PI2-Estufa/all-documents-PI2/Fotos e vídeos/Estufa pronta/IMG-20180627-WA0025.jpg

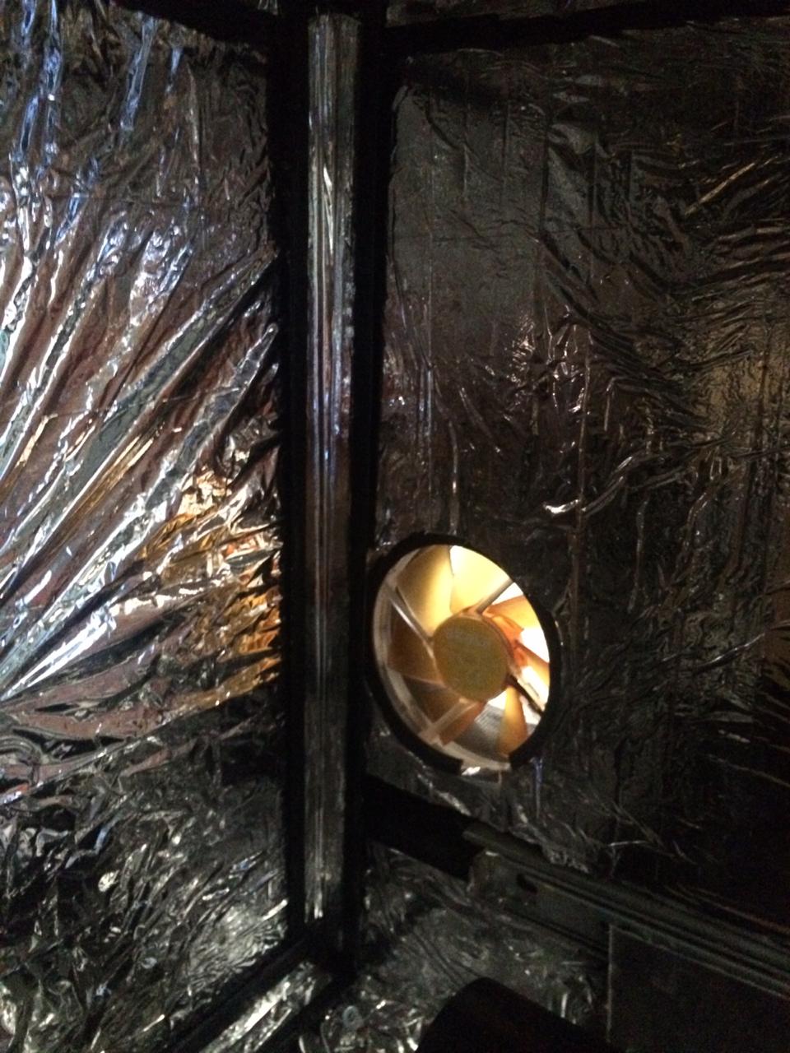
Fotos e vídeos/Estufa pronta/IMG-20180627-WA0025.jpg
