PI2-Estufa/all-documents-PI2/Fotos e vídeos/Fotos e vídeos/D4DB0FEE-51A9-4ACD-BE4B-FF01E593BEB5.jpg

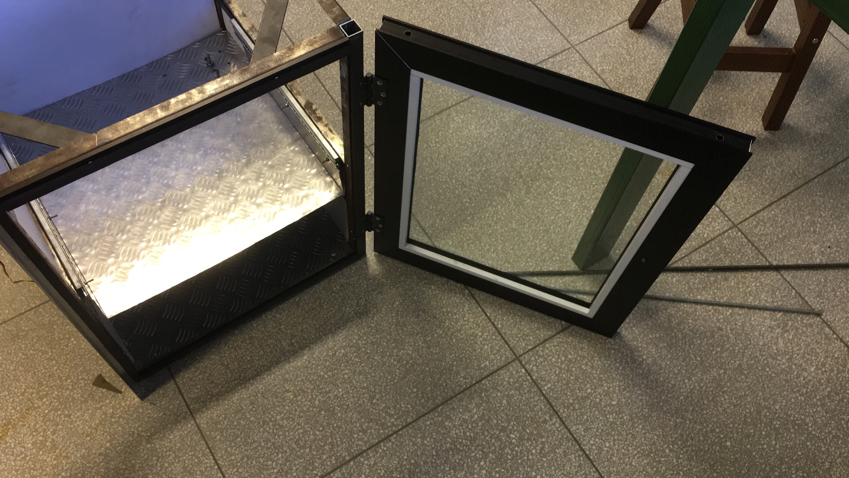
Fotos e vídeos/Fotos e vídeos/D4DB0FEE-51A9-4ACD-BE4B-FF01E593BEB5.jpg
