PI2-Estufa/all-documents-PI2/Estrutura/Report Preview Estufa - Tranferência de Calor.pdf

# Project

First Saved | Wednesday, June 27, 2018
Last Saved | Thursday, June 28, 2018
Product Version | 19.0 Release
Save Project Before Solution | No
Save Project After Solution | No
Project | Page 1 of 17

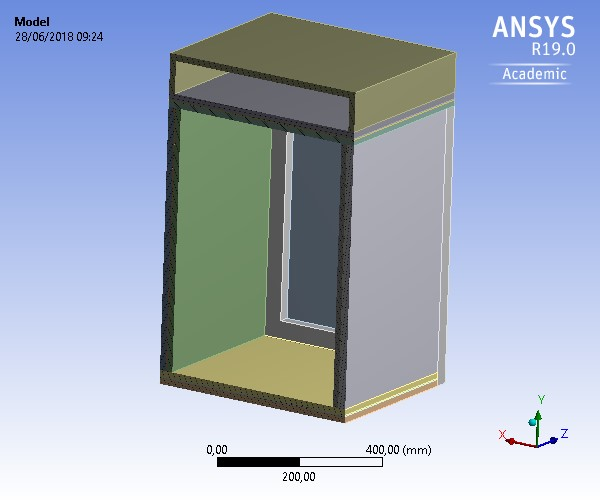
[picture p45: figure]

file:///C:/Users/Thiago/AppData/Roaming/Ansys/v190/Mechanical_Report/Mechanic... 28/06/2018

# Contents

l Units

l Model (A4)
¡ Geometry
n Parts
¡ Coordinate Systems
¡ Connections
n Contacts
n Contact Regions
¡ Mesh
¡ Transient Thermal (A5)
n Initial Temperature
n Analysis Settings
n Loads
n Solution (A6)
n Solution Information
n Result Charts
n Results

l Material Data
¡ Air(Atmospheric)
¡ PVC
¡ Isopor
¡ Wood
¡ Aluminum Alloy
¡ Glass

# Units

TABLE 1

# Model (A4)

Unit System | Metric (mm, kg, N, s, mV, mA) Degrees rad/s Celsius
Angle | Degrees
Rotational Velocity | rad/s
Temperature | Celsius

## Geometry

TABLE 2 Model (A4) > Geometry

TABLE 3 Model (A4) > Geometry > Parts

Object Name | Geometry
State | Fully Defined
Definition
Source | C:\Users\Thiago\Desktop\Estufa_camadas\estufa_camadas_files\dp0\SYS\DM\SYS.scdoc
Type | SpaceClaim
Length Unit | Meters
Element Control | Program Controlled
Display Style | Body Color
Bounding Box
Length X | 535, mm
Length Y | 835, mm
Length Z | 570, mm
Properties
Volume | 2,3479e+008 mm³ Mass 33,764 kg
Scale Factor Value | 1,
Statistics
Bodies | 19
Active Bodies | 19
Nodes | 27281
Elements | None 4421 Mesh Metric

Basic Geometry Options
Solid Bodies | Yes
Surface Bodies | Yes
Line Bodies | Yes
Parameters | Independent
Parameter Key
Attributes | Yes
Attribute Key
Named Selections | Yes
Named Selection Key Material Properties | Yes

Advanced Geometry Options
Use Associativity | Yes
Coordinate Systems | Yes
Coordinate System Key
Reader Mode Saves Updated File | No
Use Instances | Yes
Smart CAD Update | Yes
Compare Parts On Update | No
Analysis Type | None 3-D Mixed Import Resolution
Decompose Disjoint Geometry | Yes
Enclosure and Symmetry Processing | Yes
Project | Page 2 of 17

TABLE 4 Model (A4) > Geometry > Parts

Object Name | parte_tras\forro | parte_tras\pvc | parte_tras\isopor | parte_baixo\isopor | parte_baixo\pvc | parte_baixo\forro | parte_esquerda\isopor | parte_esquerda\pvc | parte_esquerda\forro
State | | | | | | Meshed Graphics Properties
Visible | | | | | | Yes
Transparency | | | | | | 1
Definition
Suppressed | | | | | | No
Stiffness Behavior | | | | | | Flexible
Coordinate
System | Default Coordinate System
Reference
Temperature | By Environment
Behavior | | | | | | None Material
Assignment | Air
(Atmospheric) | PVC | Isopor | PVC | Air(Atmospheric) | Isopor | PVC | Air(Atmospheric)
Nonlinear Effects | | | | | | Yes
Thermal Strain
Effects | | | | | | Yes
Bounding Box
Length X | 535, mm | 17, mm | 3,5 mm | 15, mm
Length Y | | 665, mm | | 17, mm | 3, mm | 15, mm | | | 665, mm
Length Z | 15, mm | 3, mm | 17, mm | | 535, mm | | | | 500, mm
Properties
Volume | 5,3366e+006 mm³ | 1,0673e+006 mm³ | 6,0482e+006 mm³ | 4,8658e+006 mm³ | 8,5867e+005 mm³ | 4,2934e+006 mm³ | 5,6525e+006 mm³ | 1,1638e+006 mm³ | 4,9875e+006 mm
Mass | 6,5374e-003 kg | 1,2808 kg | 0,30241 kg | 0,24329 kg | 1,0304 kg | 5,2594e-003 kg | 0,28263 kg | 1,3965 kg | 6,1097e
Centroid X | 267,5 mm | 8,5 mm | 18,75 mm | 28, mm
Centroid Y | 367,5 mm | 8,5 mm | 18,5 mm | 27,5 mm | 367,5 mm
Centroid Z | -507,5 mm | -516,5 mm | -526,5 mm | -267,5 mm | -250, mm
Moment of Inertia
Ip1 | 241,04 kg·mm² | 47201 kg·mm² | 11152 kg·mm² | 5808,9 kg·mm² | 24578 kg·mm² | 125,55 kg·mm² | 16303 kg·mm² | 80558 kg·mm² | 352,44 kg·mm
Moment of Inertia
Ip2 | 156,05 kg·mm² | 30551 kg·mm² | 7220,4 kg·mm² | 11606 kg·mm² | 49155 kg·mm² | 250,89 kg·mm² | 5894,8 kg·mm² | 29095 kg·mm² | 127,4
Moment of Inertia
Ip3 | 396,84 kg·mm² | 77750 kg·mm² | 18357 kg·mm² | 5808,9 kg·mm² | 24578 kg·mm² | 125,55 kg·mm² | 10422 kg·mm² | 51465 kg·mm² | 225,27 kg·mm
| | | | | | Statistics
Nodes | | 1206 | | | 1131 | | | | 1206
Elements | 154 | 144 | 154 Mesh Metric | None

CAD Attributes
PartTolerance: | 0,00000001
Color:192.192.192
Object Name | Component8\pvc | Component10
\forro

Component11
\pvc

Component12
\isopor | madeira\Solid | porta\Solid | vidro\Solid | ar\Solid
State | Meshed | Hidden Graphics Properties
Visible | Yes | No
Transparency | 1
Definition
Suppressed | No
Stiffness Behavior | Flexible
Coordinate System | Default Coordinate System
Reference Temperature | By Environment
Behavior | None Material
Assignment | PVC | Air(Atmospheric) | PVC | Isopor | Wood | Aluminum Alloy | Glass | Air (Atmospheric)
Nonlinear Effects | Yes
Thermal Strain Effects | Yes
Bounding Box
Length X | 3,5 mm | 535, mm | 375, mm | 464, mm
Length Y | 665, mm | 15, mm | 3, mm | 17, mm | 100, mm | 700, mm | 540, mm | 700, mm
Length Z | 500, mm | 570, mm | | | | 35, mm | 7, mm | 500, mm
Properties
Volume | 1,1637e+006 mm³ 1,3965 kg | 4,5743e+006 mm³ 5,6035e-003 kg | 9,1485e+005 mm³ 1,0978 kg | 5,1842e+006 mm³ 0,25921 kg | 8,2065e+006 mm³ 5,7446 kg | 6,02e+006 mm³ 16,675 kg | 1,4175e+006 mm³ 3,5437 kg | 1,624e+008 mm³ Mass 0,19894 kg
Centroid X | 516,25 mm | 267,5 mm
Centroid Y | 367,5 mm | 707,5 mm | 716,5 mm | 726,5 mm | 808,09 mm | 350, mm | | 385, mm
Centroid Z | -250, mm | | | | | 17,5 mm | 31,5 mm | -250, mm
Moment of Inertia Ip1 | 80557 kg·mm² | 151,82 kg·mm² | 29725 kg·mm² | 7024,3 kg·mm² | 2,0907e+005 kg·mm² | 1,0072e+006 kg·mm² | 86128 kg·mm² | 12268 kg·mm²
Moment of Inertia Ip2 | 29095 kg·mm² | 285,37 kg·mm² | 55909 kg·mm² | 13201 kg·mm² | 3,8724e+005 kg·mm² | 6,3765e+005 kg·mm² | 41543 kg·mm² | 7713,8 kg·mm²
Moment of Inertia Ip3 | 51465 kg·mm² | 133,76 kg·mm² | 26186 kg·mm² | 6188,9 kg·mm² | 1,8746e+005 kg·mm² | 1,6414e+006 kg·mm² | 1,2764e+005 kg·mm² | 11693 kg·mm²

Statistics
Nodes | 1206 | 1220 | 1494 | 773 | 932 | 6175
Elements | 154 | 156 | 679 | 79 | 117 | 1260 Mesh Metric | None

CAD Attributes
PartTolerance: | 0,00000001
Color:192.192.192
Color:175.175.143
Color:0.0.0
Color:255.255.255

## Coordinate Systems

Project | Page 3 of 17

TABLE 5 Model (A4) > Coordinate Systems > Coordinate System

Object Name | Global Coordinate System
State | Fully Defined
Definition
Type | Cartesian
Coordinate System ID | 0,
Origin
Origin X | 0, mm
Origin Y | 0, mm
Origin Z | 0, mm
Directional Vectors
X Axis Data | [ 1, 0, 0, ]
Y Axis Data | [ 0, 1, 0, ]
Z Axis Data | [ 0, 0, 1, ]

## Connections

TABLE 6 Model (A4) > Connections

TABLE 7 Model (A4) > Connections > Contacts

TABLE 8 Model (A4) > Connections > Contacts > Contact Regions

TABLE 9

Object Name | Connections
State | Fully Defined
Auto Detection Generate Automatic Connection On Refresh | Yes

Transparency
Enabled | Yes
Object Name | Contacts
State | Fully Defined
Definition
Connection Type Contact
Scope
Scoping Method | Geometry Selection
Geometry | All Bodies
Auto Detection
Tolerance Type | Slider
Tolerance Slider | 0,
Tolerance Value | 2,8596 mm
Use Range | No
Face/Face | Yes
Face Overlap Tolerance | Off
Cylindrical Faces | Include
Face/Edge | No
Edge/Edge | No
Priority | Include All Group By Bodies
Search Across | Bodies
Statistics
Connections | 51
Active Connections | 51
Object Name | Contact Region

Contact Region

2 | Contact Region 3 | Contact Region 4 | Contact Region 5 | Contact Region 6

Contact Region 7

Contact Region 8

Contact Region 9

Contact Region
10
State | Fully Defined
| | | Scope
Scoping Method | Geometry Selection
Contact | 1 Face
Target | 1 Face
Contact
Bodies | parte_tras\forro
Target
Bodies | parte_tras\pvc | parte_baixo\forro | parte_esquerda\isopor | parte_esquerda\pvc | parte_esquerda\forro | Component7 \isopor

Component9
\forro

Component8
\pvc

Component10
\forro | parte_tras\isopor
Protected | | | | | No
| | | | | Definition
Type | | | | | Bonded
Scope Mode | Automatic
Behavior | Program Controlled
Trim Contact | Program Controlled
Trim
Tolerance | 2,8596 mm
Suppressed | | | | | No
| | | | | Advanced
Formulation | Program Controlled
Small Sliding | Program Controlled
Detection Method | Program Controlled

Elastic Slip
Tolerance | Program Controlled
Thermal Conductance | Program Controlled
Pinball Region | Program Controlled

Geometric Modification
Contact Geometry Correction | | | | | None

Target
Geometry Correction | | | | | None
Project | Page 4 of 17

Model (A4) > Connections > Contacts > Contact Regions

TABLE 10 Model (A4) > Connections > Contacts > Contact Regions

TABLE 11 Model (A4) > Connections > Contacts > Contact Regions

Object Name Contact Region 12

Contact Region
13

Contact Region 14

Contact Region
15

Contact Region 16

Contact Region
17
| | | | Contact Region 18 | Contact Region 19 | Contact Region 20 | Contact Region 21
State | Fully Defined
| | | Scope
Scoping Method | Geometry Selection
Contact | 1 Face
Target | 1 Face
Contact
Bodies | parte_tras\pvc | parte_tras\isopor | parte_baixo\isopor | parte_baixo\pvc | parte_baixo\forro
Target
Bodies

Component10

\forro | parte_baixo\forro | Component10
\forro | parte_baixo\pvc | porta\Solid | parte_baixo\forro | porta\Solid | parte_esquerda\isopor | parte_esquerda\pvc | parte_esquerda\forro
Protected | No
| | | Definition
Type | Bonded
Scope Mode | Automatic
Behavior | Program Controlled
Trim Contact | Program Controlled
Trim
Tolerance | 2,8596 mm
Suppressed | No
| | | Advanced
Formulation | Program Controlled
Small Sliding | Program Controlled
Detection Method | Program Controlled

Elastic Slip
Tolerance | Program Controlled
Thermal Conductance | Program Controlled
Pinball Region | Program Controlled

Geometric Modification
Contact Geometry Correction
None

Target
Geometry Correction

None

Object Name | Contact Region 23 | Contact Region 24 | Contact Region 25 | Contact Region 26 | Contact Region 27 | Contact Region 28 | Contact Region 29 | Contact Region 30 | Contact Region 31 | Contact Region 32 | Contact Region 33
State | Fully Defined
Scope
Scoping Method | Geometry Selection
Contact | 1 Face
Target | 1 Face
Contact Bodies | parte_baixo\forro | parte_esquerda\isopor | parte_esquerda\pvc | parte_esquerda\forro
Target Bodies | Component9 \forro | Component8 \pvc | porta\Solid | parte_esquerda\pvc | Component10 \forro | porta\Solid | parte_esquerda\forro | Component10 \forro | porta\Solid | Component10 \forro | porta\Solid
Protected | No
Definition
Type | Bonded
Scope Mode | Automatic
Behavior | Program Controlled
Trim Contact | Program Controlled
Trim Tolerance | 2,8596 mm
Suppressed | No
Advanced
Formulation | Program Controlled
Small Sliding | Program Controlled
Detection Method | Program Controlled
Elastic Slip Tolerance | Program Controlled
Thermal Conductance | Program Controlled
Pinball Region | Program Controlled

Geometric Modification
Contact Geometry Correction | None
Target Geometry Correction | None
Object Name | Contact Region 34 | Contact Region 35 | Contact Region 36 | Contact Region 37 | Contact Region 38 | Contact Region 39 | Contact Region 40 | Contact Region 41 | Contact Region 42 | Contact Region 43 | Contact Region 44
State | Fully Defined
Scope
Scoping Method | Geometry Selection
Contact | 1 Face
Target | 1 Face
Contact Bodies | Component7\isopor | Component9\forro | Component8\pvc | Component10\forro | Component11 \pvc
Target Bodies | Component8 \pvc | Component10 \forro | porta\Solid | Component8 \pvc | Component10 \forro | porta\Solid | Component10 \forro | porta\Solid | Component11 \pvc | porta\Solid | Component12 \isopor
Protected | No
Definition
Project | Page 5 of 17

TABLE 12 Model (A4) > Connections > Contacts > Contact Regions

Type | Bonded
Scope Mode | Automatic
Behavior | Program Controlled
Trim Contact | Program Controlled
Trim Tolerance | 2,8596 mm
Suppressed | No
Advanced
Formulation | Program Controlled
Small Sliding | Program Controlled
Detection Method | Program Controlled
Elastic Slip Tolerance | Program Controlled
Thermal Conductance | Program Controlled
Pinball Region | Program Controlled Geometric Modification
Contact Geometry Correction | None
Target Geometry Correction | None
Object Name | Contact Region 45 | Contact Region 46 | Contact Region 47 | Contact Region 48 | Contact Region 49 | Contact Region 50 | Contact Region 51
State | Fully Defined
Scope
Scoping Method | Geometry Selection
Contact | 1 Face | 4 Faces | 1 Face
Target | 1 Face | 4 Faces | 1 Face
Contact Bodies | Component12\isopor | porta\Solid | parte_tras\forro | parte_baixo\forro | parte_esquerda\forro | Component9\forro | porta\Solid
Target Bodies | madeira\Solid | vidro\Solid | ar\Solid
Protected | No
Definition
Type | Bonded
Scope Mode | Automatic
Behavior | Program Controlled
Trim Contact | Program Controlled
Trim Tolerance | 2,8596 mm
Suppressed | No
Advanced
Formulation | Program Controlled
Small Sliding | Program Controlled
Detection Method | Program Controlled
Elastic Slip Tolerance | Program Controlled
Thermal Conductance | Program Controlled
Pinball Region | Program Controlled Geometric Modification
Contact Geometry Correction | None
Target Geometry Correction | None

## Mesh

TABLE 13 Model (A4) > Mesh

Object Name | Mesh
State | Solved
Display
Display Style | Body Color
Defaults
Physics Preference | Mechanical
Relevance | 0
Element Order | Program Controlled
Sizing
Size Function | Adaptive
Relevance Center | Coarse
Element Size | Default Mesh Defeaturing Yes
Defeature Size | Default
Transition | Fast
Initial Size Seed | Assembly
Span Angle Center | Coarse
Bounding Box Diagonal | 1143,80 mm
Average Surface Area | 1,1221e+005 mm² Minimum Edge Length 3,0 mm

Quality
Check Mesh Quality | Yes, Errors
Error Limits | Standard Mechanical
Target Quality | Default (0.050000)
Smoothing | Medium
Mesh Metric | None
Inflation
Use Automatic Inflation | None
Inflation Option | Smooth Transition
Transition Ratio | 0,272
Maximum Layers | 1,2 5 Growth Rate
Inflation Algorithm | Pre
View Advanced Options | No
Advanced
Number of CPUs for Parallel Part Meshing | Program Controlled
Straight Sided Elements | No
Number of Retries | Default (4)
Project | Page 6 of 17

# Transient Thermal (A5)

TABLE 14 Model (A4) > Analysis

TABLE 15 Model (A4) > Transient Thermal (A5) > Initial Condition

TABLE 16 Model (A4) > Transient Thermal (A5) > Analysis Settings

TABLE 17 Model (A4) > Transient Thermal (A5) > Analysis Settings

Step-Specific "Step Controls"

TABLE 18 Model (A4) > Transient Thermal (A5) > Loads

Rigid Body Behavior | Dimensionally Reduced
Triangle Surface Mesher | Program Controlled
Topology Checking | Yes
Pinch Tolerance | Please Define Generate Pinch on Refresh No

Statistics
Nodes | 27281
Elements | 4421
Object Name | Transient Thermal (A5)
State | Solved
Definition
Physics Type | Thermal
Analysis Type | Transient
Solver Target | Mechanical APDL Options
Generate Input Only | No
Object Name | Initial Temperature
State | Fully Defined
Definition
Initial Temperature | Uniform Temperature
Initial Temperature Value | 22, °C
Object Name | Analysis Settings
State | Fully Defined
Step Controls
Number Of Steps | 10,
Current Step Number | 10,
Step End Time | 7200, s
Auto Time Stepping | Program Controlled
Initial Time Step | 520, s 52, s Minimum Time Step 5,2 s Maximum Time Step
Time Integration | On
| Solver Controls
Solver Type | Program Controlled
| Radiosity Controls
Radiosity Solver | Program Controlled
Flux Convergence | 1,e-004 Maximum Iteration 1000,
Solver Tolerance | 1,e-007 W/mm² Over Relaxation 0,1
Hemicube Resolution | 10,
Nonlinear Controls
Heat Convergence | Program Controlled
Temperature Convergence | Program Controlled
Line Search | Program Controlled
Nonlinear Formulation | Program Controlled Output Controls
Calculate Thermal Flux | Yes
Nodal Forces | No
Contact Miscellaneous | No General Miscellaneous No
Store Results At | All Time Points
Analysis Data Management
Solver Files Directory | C:\Users\Thiago\Desktop\Estufa_camadas\estufa_camadas_files\dp0\SYS\MECH\
Future Analysis | None
Scratch Solver Files Directory
Save MAPDL db | No
Contact Summary | Program Controlled
Delete Unneeded Files | Yes
Nonlinear Solution | Yes
Solver Units | Active System
Solver Unit System | nmm
Step | Step End Time | Initial Time Step | Minimum Time Step | Maximum Time Step
1 | 1, s | 1,e-002 s | 1,e-003 s | 0,1 s
2 | 5, s | 4,e-002 s | 4,e-003 s | 0,4 s
3 | 10, s | 5,e-002 s | 5,e-003 s | 0,5 s
4 | 50, s | 0,4 s | 4,e-002 s | 4, s
5 | 100, s | 0,5 s | 5,e-002 s | 5, s
6 | 200, s | 1, s | 0,1 s | 10, s
7 | 500, s | 3, s | 0,3 s | 30, s
8 | 1000, s | 5, s | 0,5 s | 50, s
9 | 2000, s | 10, s | 1, s | 100, s
10 | 7200, s | 52, s | 5,2 s | 520, s
Object Name | Convection | Convection 2
State | Fully Defined | Suppressed
Scope
Project | Page 7 of 17

FIGURE 1 Model (A4) > Transient Thermal (A5) > Convection

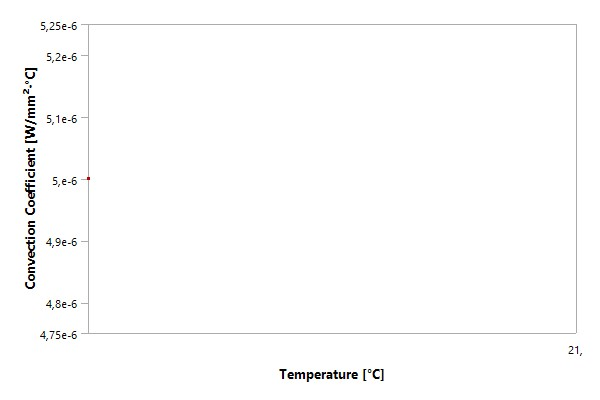
[picture p46: figure]

TABLE 19 Model (A4) > Transient Thermal (A5) > Convection

FIGURE 2 Model (A4) > Transient Thermal (A5) > Convection 2

TABLE 20 Model (A4) > Transient Thermal (A5) > Convection 2

Scoping Method | Geometry Selection
Geometry | 41 Faces | 6 Faces
| Definition
Type | Convection
Film Coefficient | 5,e-006 W/mm²·°C (step applied)
Coefficient Type | Average Film Temperature
Ambient Temperature | 30, °C (step applied) | 20, °C (step applied)
Convection Matrix | Program Controlled
Suppressed | No | Yes
Temperature [°C] | Convection Coefficient [W/mm²·°C]
21, | 5,e-006
Temperature [°C] | Convection Coefficient [W/mm²·°C]
21, | 5,e-006

## Solution (A6)

TABLE 21 Model (A4) > Transient Thermal (A5) > Solution

TABLE 22 Model (A4) > Transient Thermal (A5) > Solution (A6) > Solution Information

Object Name | Solution (A6)
State | Solved
Adaptive Mesh Refinement
Max Refinement Loops | 1,
Refinement Depth | 2,
Information
Status | Done MAPDL Elapsed Time | 3 m 17 s MAPDL Memory Used | 421, MB MAPDL Result File Size | 417,31 MB

Post Processing
Beam Section Results | No
Object Name | Solution Information
State | Solved
Solution Information
Project | Page 8 of 17

TABLE 23 Model (A4) > Transient Thermal (A5) > Solution (A6) > Solution Information > Result Charts

FIGURE 3 Model (A4) > Transient Thermal (A5) > Solution (A6) > Solution Information > Temperature - Global Maximum

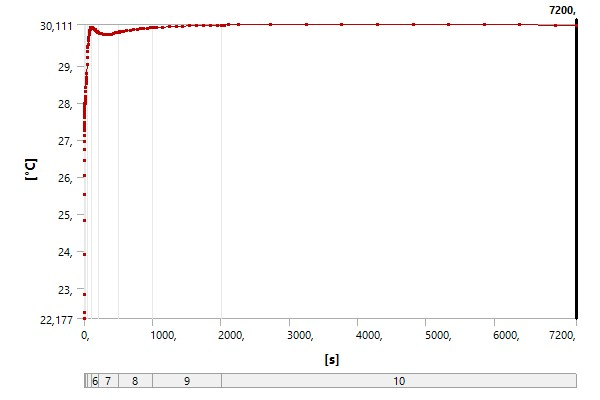
[picture p47: figure]

FIGURE 4 Model (A4) > Transient Thermal (A5) > Solution (A6) > Solution Information > Temperature - Global Minimum

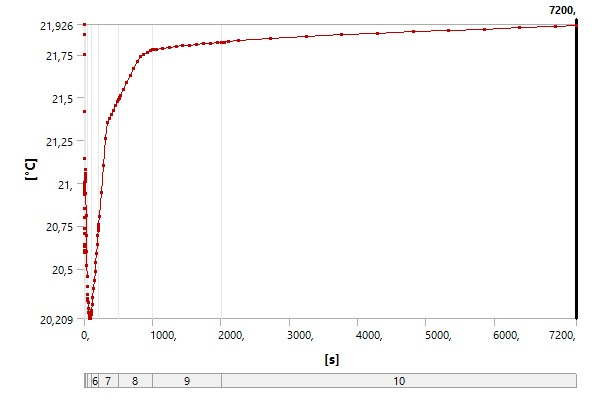
[picture p48: figure]

TABLE 24 Model (A4) > Transient Thermal (A5) > Solution (A6) > Results

Solution Output | Solver Output
Update Interval | 2,5 s
Display Points | All
FE Connection Visibility
Activate Visibility | Yes
Display | All FE Connectors
Draw Connections Attached To | All Nodes
Line Color | Connection Type
Visible on Results | No
Line Thickness | Single
Display Type | Lines
Object Name | Temperature - Global Maximum | Temperature - Global Minimum
State | Solved
Scope
Scoping Method | Global Maximum | Global Minimum
| Definition
Type | Temperature
Suppressed | No
Results Minimum | 22,177 °C | 20,209 °C Maximum | 30,111 °C | 21,926 °C
Object Name | Temperature | Total Heat Flux | Directional Heat Flux
State | Solved
Scope
Scoping Method | Geometry Selection
Geometry | All Bodies
Definition
Type | Temperature | Total Heat Flux | Directional Heat Flux
By | Time
Display Time | Last
Calculate Time History | Yes
Identifier
Suppressed | No Orientation | X Axis
Coordinate System | | Global Coordinate System
Results
Project | Page 9 of 17

FIGURE 5 Model (A4) > Transient Thermal (A5) > Solution (A6) > Temperature

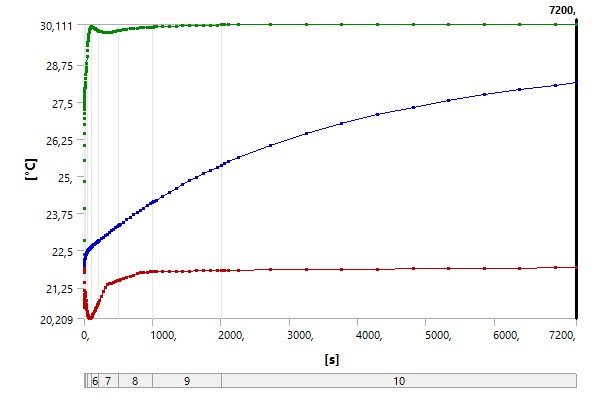
[picture p49: figure]

TABLE 25 Model (A4) > Transient Thermal (A5) > Solution (A6) > Temperature

Minimum | 21,919 °C | 5,9057e-009 W/mm² | -9,1686e-005 W/mm² Maximum | 30,094 °C | 1,0219e-004 W/mm² | 9,1745e-005 W/mm²
Average | 28,145 °C | 3,732e-006 W/mm² | 3,623e-008 W/mm² Minimum Occurs On | Component11\pvc | ar\Solid | vidro\Solid Maximum Occurs On | Component10\forro | porta\Solid | vidro\Solid Minimum Value Over Time Minimum | 20,209 °C | 1,4257e-013 W/mm² | -1,3387e-004 W/mm² Maximum | 21,926 °C | 1,5242e-008 W/mm² | -1,7653e-005 W/mm² Maximum Value Over Time Minimum | 22,177 °C | 1,9472e-005 W/mm² | 1,8369e-005 W/mm² Maximum | 30,111 °C | 1,3957e-004 W/mm² | 1,3095e-004 W/mm²

Information
Time | 7200, s
Load Step | 10
Substep | 13
Iteration Number | 130
Integration Point Results
Display Option | Averaged
Average Across Bodies | No
Time [s] | Minimum [°C] | Maximum [°C] | Average [°C]
1,e-002 | 21,926 | 22,177 | 22,001
2,e-002 | 21,867 | 22,349 | 22,003
5,e-002 | 21,754 | 22,821 | 22,006
0,14 | 21,418 | 23,914 | 22,016
0,24 | 21,141 | 24,828 | 22,025
0,34 | 20,941 | 25,516 | 22,034
0,44 | 20,8 | 26,036 | 22,041
0,54 | 20,705 | 26,429 | 22,048
0,64 | 20,644 | 26,727 | 22,054
0,74 | 20,609 | 26,953 | 22,06
0,84 | 20,593 | 27,125 | 22,065
0,94 | 20,592 | 27,257 | 22,07
1, | 20,596 | 27,324 | 22,072
1,04 | 20,6 | 27,363 | 22,074
1,08 | 20,605 | 27,399 | 22,076
1,2 | 20,63 | 27,477 | 22,081
1,56 | 20,733 | 27,596 | 22,094
1,96 | 20,853 | 27,665 | 22,106
2,36 | 20,934 | 27,707 | 22,118
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
4288, | 21,875 | 30,109 | 27,066
4808, | 21,884 | 30,107 | 27,321
5328, | 21,892 | 30,104 | 27,544
5848, | 21,9 | 30,1 | 27,739
6368, | 21,908 | 30,098 | 27,91
6888, | 21,915 | 30,096 | 28,061
7200, | 21,919 | 30,094 | 28,145
1010, | 30,025 | 24,137
Project | Page 11 of 17

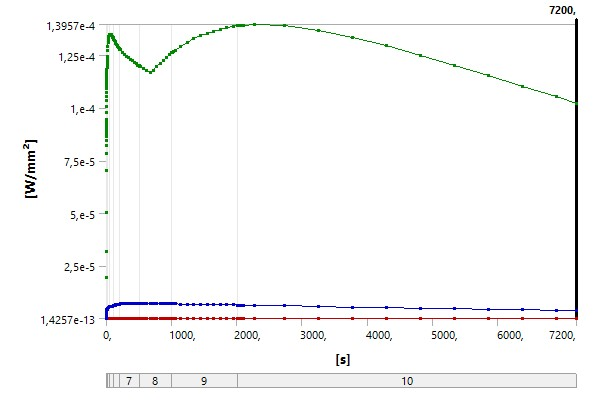
[picture p50: figure]

TABLE 26 Model (A4) > Transient Thermal (A5) > Solution (A6) > Total Heat Flux

Time [s] | Minimum [W/mm²] | Maximum [W/mm²] | Average [W/mm²]
1,e-002 | 2,4636e-011 | 1,9472e-005 | 8,7014e-008
2,e-002 | 2,6672e-011 | 3,1955e-005 | 1,3989e-007
5,e-002 | 3,555e-011 | 5,0501e-005 | 2,6233e-007
0,14 | 4,8685e-011 | 7,0328e-005 | 5,612e-007
0,24 | 1,9333e-011 | 7,8473e-005 | 8,4855e-007
0,34 | 4,3081e-011 | 8,2326e-005 | 1,0979e-006
0,44 | 3,2578e-011 | 8,4705e-005 | 1,3155e-006
0,54 | 5,0698e-011 | 8,6501e-005 | 1,5071e-006
0,64 | 4,5653e-011 | 8,8021e-005 | 1,6771e-006
0,74 | 3,3358e-011 | 8,9382e-005 | 1,8291e-006
0,84 | 1,5254e-011 | 9,0636e-005 | 1,966e-006
0,94 | 1,1838e-011 | 9,1809e-005 | 2,0901e-006
1, | 2,3272e-011 | 9,2489e-005 | 2,1604e-006
1,04 | 2,091e-011 | 9,2933e-005 | 2,2055e-006
1,08 | 2,0322e-011 | 9,3367e-005 | 2,249e-006
1,2 | 1,2793e-011 | 9,4588e-005 | 2,3669e-006
1,56 | 2,7173e-012 | 9,7735e-005 | 2,6439e-006
1,96 | 3,6677e-012 | 1,0074e-004 | 2,8871e-006
2,36 | 2,4942e-012 | 1,0332e-004 | 3,0837e-006
2,76 | 5,6833e-012 | 1,0554e-004 | 3,2456e-006
3,16 | 7,3197e-012 | 1,0746e-004 | 3,3816e-006
3,56 | 8,5153e-013 | 1,0914e-004 | 3,4974e-006
3,96 | 2,9243e-012 | 1,106e-004 | 3,5975e-006
4,36 | 1,4257e-013 | 1,119e-004 | 3,6853e-006
4,76 | 9,5297e-013 | 1,1306e-004 | 3,763e-006
5, | 2,7927e-012 | 1,137e-004 | 3,8066e-006
5,05 | 2,8117e-012 | 1,1384e-004 | 3,8156e-006
5,1 | 2,1622e-012 | 1,1397e-004 | 3,8244e-006
5,25 | 1,0145e-012 | 1,1435e-004 | 3,8497e-006
5,7 | 2,2533e-012 | 1,1537e-004 | 3,9174e-006
6,2 | 8,6978e-013 | 1,1639e-004 | 3,9848e-006
6,7 | 1,3576e-012 | 1,1733e-004 | 4,0456e-006
7,2 | 2,2497e-012 | 1,1819e-004 | 4,1011e-006
7,7 | 6,0898e-013 | 1,1899e-004 | 4,1519e-006
8,2 | 2,3862e-012 | 1,1973e-004 | 4,1987e-006
8,7 | 3,6239e-012 | 1,2044e-004 | 4,2425e-006
9,2 | 3,4504e-012 | 1,211e-004 | 4,2835e-006
9,7 | 3,1285e-012 | 1,2173e-004 | 4,3221e-006
10, | 2,8934e-012 | 1,2209e-004 | 4,3446e-006
10,4 | 2,5252e-012 | 1,2256e-004 | 4,3731e-006
10,8 | 2,1202e-012 | 1,2301e-004 | 4,4002e-006
12, | 8,348e-013 | 1,2422e-004 | 4,4718e-006
15,6 | 1,628e-012 | 1,2699e-004 | 4,6431e-006
19,6 | 2,9254e-012 | 1,2929e-004 | 4,8363e-006
23,6 | 1,0457e-012 | 1,31e-004 | 5,0386e-006
27,6 | 9,505e-013 | 1,3227e-004 | 5,2117e-006
31,6 | 1,0654e-012 | 1,332e-004 | 5,3452e-006
35,6 | 9,2526e-013 | 1,3387e-004 | 5,4451e-006
39,6 | 8,6162e-013 | 1,3435e-004 | 5,5184e-006
43,6 | 8,2566e-013 | 1,3466e-004 | 5,5709e-006
47,6 | 8,2695e-013 | 1,3486e-004 | 5,6073e-006
50, | 8,5198e-013 | 1,3494e-004 | 5,6245e-006
50,5 | 8,5943e-013 | 1,3496e-004 | 5,6279e-006
51, | 8,6735e-013 | 1,3497e-004 | 5,6311e-006
52,5 | 9,0196e-013 | 1,35e-004 | 5,6392e-006
57, | 1,1688e-012 | | 5,6529e-006
62, | 1,8722e-012 | 1,3492e-004 | 5,6609e-006
67, | 2,1679e-012 | 1,3479e-004 | 5,6697e-006
72, | 2,4785e-012 | 1,346e-004 | 5,6881e-006
77, | 3,1795e-012 | 1,3439e-004 | 5,7161e-006
82, | 3,0252e-012 | 1,3415e-004 | 5,7466e-006
87, | 2,861e-012 | 1,339e-004 | 5,7892e-006
92, | 3,0158e-012 | 1,3363e-004 | 5,8556e-006
97, | 3,7198e-012 | 1,3335e-004 | 5,9257e-006
100, | 3,7936e-012 | 1,3318e-004 | 5,9678e-006
101, | 3,8099e-012 | 1,3312e-004 | 5,9818e-006
102, | 3,829e-012 | 1,3307e-004 | 5,9957e-006
Project | Page 12 of 17

FIGURE 7 Model (A4) > Transient Thermal (A5) > Solution (A6) > Directional Heat Flux

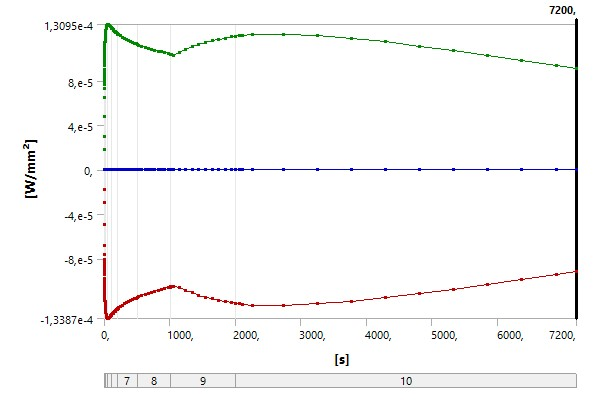
[picture p51: figure]

TABLE 27 Model (A4) > Transient Thermal (A5) > Solution (A6) > Directional Heat Flux

105, | 3,9088e-012 | 1,3289e-004 | 6,0363e-006
114, | 4,4378e-012 | 1,3238e-004 | 6,1482e-006
124, | 5,5737e-012 | 1,3182e-004 | 6,262e-006
134, | 7,3961e-012 | 1,3128e-004 | 6,3653e-006
144, | 1,0029e-011 | 1,3075e-004 | 6,4588e-006
154, | 1,3611e-011 | 1,3024e-004 | 6,5434e-006
164, | 1,7796e-011 | 1,2975e-004 | 6,6199e-006
174, | 2,3753e-011 | 1,2927e-004 | 6,6892e-006
184, | 3,1511e-011 | 1,2882e-004 | 6,7518e-006
194, | 4,0247e-011 | 1,2838e-004 | 6,8084e-006
200, | 4,6021e-011 | 1,2813e-004 | 6,8404e-006
203, | 4,9042e-011 | 1,2799e-004 | 6,8558e-006
206, | 5,2197e-011 | 1,2787e-004 | 6,8708e-006
215, | 6,2846e-011 | 1,275e-004 | 6,9118e-006
242, | 1,0249e-010 | 1,2651e-004 | 7,0055e-006
272, | 1,5312e-010 | 1,2551e-004 | 7,0827e-006
302, | 2,116e-010 | 1,246e-004 | 7,139e-006
332, | 2,486e-010 | 1,2376e-004 | 7,1789e-006
362, | 2,0962e-010 | 1,2298e-004 | 7,2059e-006
392, | 3,2799e-010 | 1,2225e-004 | 7,2228e-006
422, | 3,809e-010 | 1,2156e-004 | 7,2319e-006
452, | 4,7394e-010 | 1,2091e-004 | 7,2348e-006
482, | 2,0187e-010 | 1,2029e-004 | 7,2334e-006
500, | 2,9533e-010 | 1,1992e-004 | 7,2319e-006
505, | 4,2179e-010 | 1,1979e-004 | 7,2312e-006
510, | 5,544e-010 | 1,1969e-004 | 7,2307e-006
525, | 5,7811e-010 | 1,194e-004 | 7,2283e-006
570, | 5,9497e-010 | 1,1857e-004 | 7,2151e-006
620, | 5,3647e-010 | 1,1768e-004 | 7,1956e-006
670, | 3,2557e-010 | 1,1684e-004 | 7,1721e-006
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
7,e-007
Project | Page 15 of 17

Wood > Specific Heat Constant Pressure

TABLE 38 Wood > Latent Heat

TABLE 39 Wood > Vaporization Temperature

TABLE 40 Wood > Boiling Point

TABLE 41 Wood > Binary Diffusivity

TABLE 42 Wood > Volatile Fraction

TABLE 43 Wood > Combustible Fraction

TABLE 44 Wood > Swelling Coefficient

TABLE 45 Wood > Emissivity

TABLE 46 Wood > Scattering Factor

TABLE 47 Wood > Burn Stoichiometry

TABLE 48 Wood > Burn Hreact

TABLE 49 Wood > Burn Hreact Fraction

TABLE 50 Wood > Devolatilization Model

TABLE 51 Wood > Absorption Coefficient

TABLE 52 Wood > Color

Specific Heat mJ kg^-1 C^-1 2,31e+006

Latent Heat mJ kg^-1
0,

Vaporization Temperature C 126,85

Boiling Point C
126,85

Binary Diffusivity
4,e-005

Volatile Fraction
0,8

Combustible Fraction
0,2

Swelling Coefficient
1,

Emissivity
0,9

Scattering Factor
0,9

Burn Stoichiometry
2,67

Burn Hreact
3,2789e+007

Burn Hreact Fraction
0,3

Devolatilization Model
20,

Absorption Coefficient mm^-1 0,

Red | Green | Blue
103, | 192, | 205,

## Aluminum Alloy

TABLE 53 Aluminum Alloy > Constants

TABLE 54 Aluminum Alloy > Color

TABLE 55 Aluminum Alloy > Compressive Ultimate Strength

Density | 2,77e-006 kg mm^-3
Coefficient of Thermal Expansion | 2,3e-005 C^-1
Specific Heat | 8,75e+005 mJ kg^-1 C^-1
Red | Green | Blue
138, | 104, | 46,

Compressive Ultimate Strength MPa 0,

Project | Page 16 of 17

TABLE 56 Aluminum Alloy > Compressive Yield Strength

TABLE 57 Aluminum Alloy > Tensile Yield Strength

TABLE 58 Aluminum Alloy > Tensile Ultimate Strength

TABLE 59 Aluminum Alloy > Isotropic Secant Coefficient of Thermal Expansion

TABLE 60 Aluminum Alloy > Isotropic Thermal Conductivity

TABLE 61 Aluminum Alloy > Alternating Stress R-Ratio

TABLE 62 Aluminum Alloy > Isotropic Resistivity

TABLE 63 Aluminum Alloy > Isotropic Elasticity

TABLE 64 Aluminum Alloy > Isotropic Relative Permeability

Compressive Yield Strength MPa 280,

Tensile Yield Strength MPa 280,

Tensile Ultimate Strength MPa 310,

Zero-Thermal-Strain Reference Temperature C 22,

Thermal Conductivity W mm^-1 C^-1 | Temperature C
0,114 | -100,
0,144 | 0,
0,165 | 100,
0,175 | 200,
Alternating Stress MPa | Cycles | R-Ratio
275,8 | 1700, | -1,
241,3 | 5000, | -1,
206,8 | 34000 | -1,
172,4 | 1,4e+005 | -1,
137,9 | 8,e+005 | -1,
117,2 | 2,4e+006 | -1,
89,63 | 5,5e+007 | -1,
82,74 | 1,e+008 | -1,
170,6 | 50000 | -0,5
139,6 | 3,5e+005 | -0,5
108,6 | 3,7e+006 | -0,5
87,91 | 1,4e+007 | -0,5
77,57 | 5,e+007 | -0,5
72,39 | 1,e+008 | -0,5
144,8 | 50000 | 0,
120,7 | 1,9e+005 | 0,
103,4 | 1,3e+006 | 0,
93,08 | 4,4e+006 | 0,
86,18 | 1,2e+007 | 0,
72,39 | 1,e+008 | 0,
74,12 | 3,e+005 | 0,5
70,67 | 1,5e+006 | 0,5
66,36 | 1,2e+007 | 0,5
62,05 | 1,e+008 | 0,5
Resistivity ohm mm | Temperature C
2,43e-005 | 0,
2,67e-005 | 20,
3,63e-005 | 100,
Temperature C | Young's Modulus MPa | Poisson's Ratio | Bulk Modulus MPa | Shear Modulus MPa
| 71000 | 0,33 | 69608 | 26692

Relative Permeability
1,

## Glass

TABLE 65 Glass > Constants

TABLE 66 Glass > Color

Thermal Conductivity | 1,4e-003 W mm^-1 C^-1
Density | 2,5e-006 kg mm^-3
Specific Heat | 7,5e+005 mJ kg^-1 C^-1
Red | Green | Blue
181, | 168, | 168,
Project | Page 17 of 17
