PI2-Estufa/all-documents-PI2/Reuniões/Atas/Ata da reunião - 04_06_18.docx

Data e hora | 06/04/2018 - 14:20
Participantes | Wannbaster Reis Gustavo Mairon Adaílson Santos Marcelo Martins Lucas Amoêdo Leonardo Sagmeister Thiago Dias Gabriel Augusto Rafael Abreu Stephane
Faltantes | Júlio César
Responsável pela ata | Leonardo Sagmeister

Anotações
Entregas | - Definições de escopo de estrutura; - Definições de escopo de energia;
Alterações
Planejamentos
Impedimentos e problemas
Próxima reunião
