PI2-Estufa/all-documents-PI2/Estrutura/CADs de Estrutura/estufaRF3.png

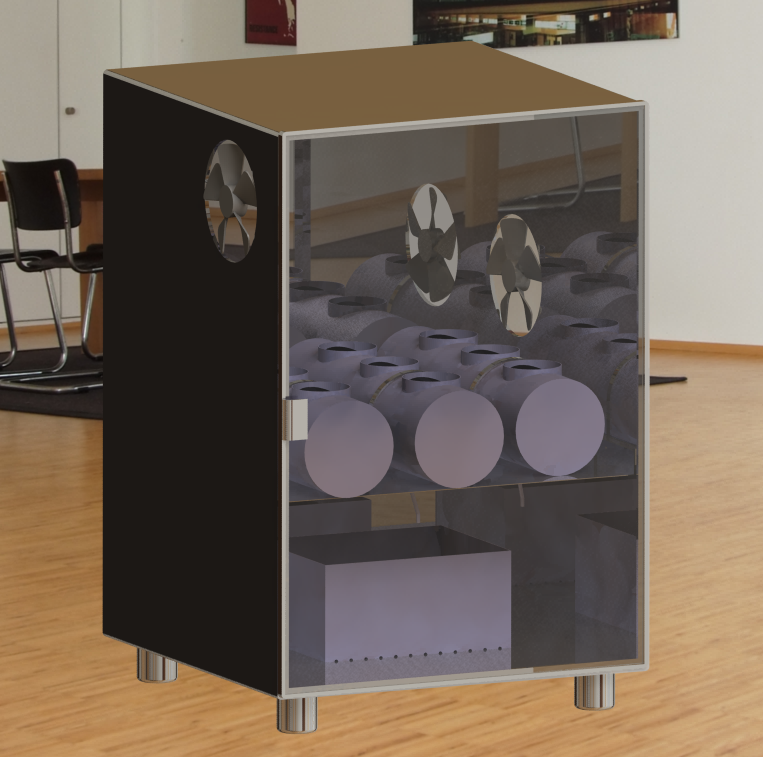
Estrutura/CADs de Estrutura/estufaRF3.png
