PI2-Estufa/all-documents-PI2/Estrutura/Imagens da Estrutura/Imagens de Softwares/300N-3andares-VonMises.jpg

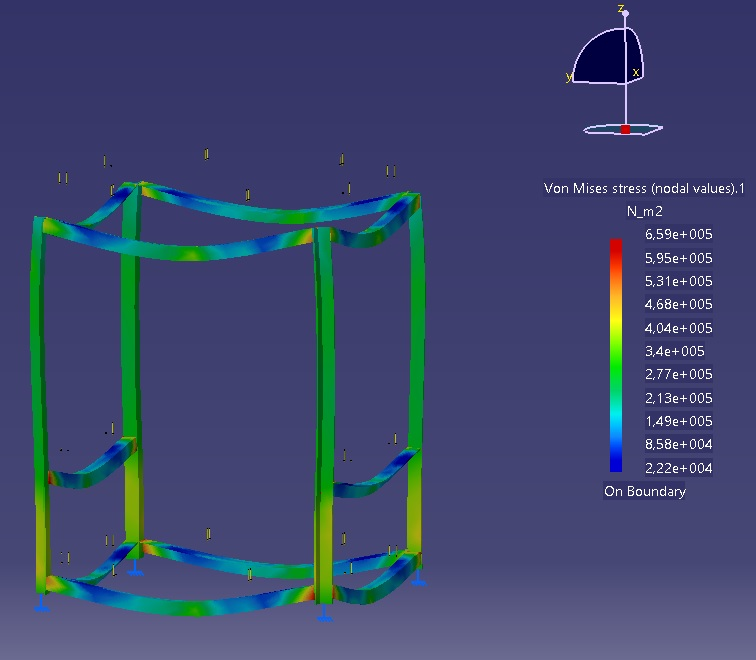
Estrutura/Imagens da Estrutura/Imagens de Softwares/300N-3andares-VonMises.jpg
