PI2-Estufa/all-documents-PI2/Estrutura/Imagens da Estrutura/Imagens de Softwares/draft1-chassi-cru.jpg

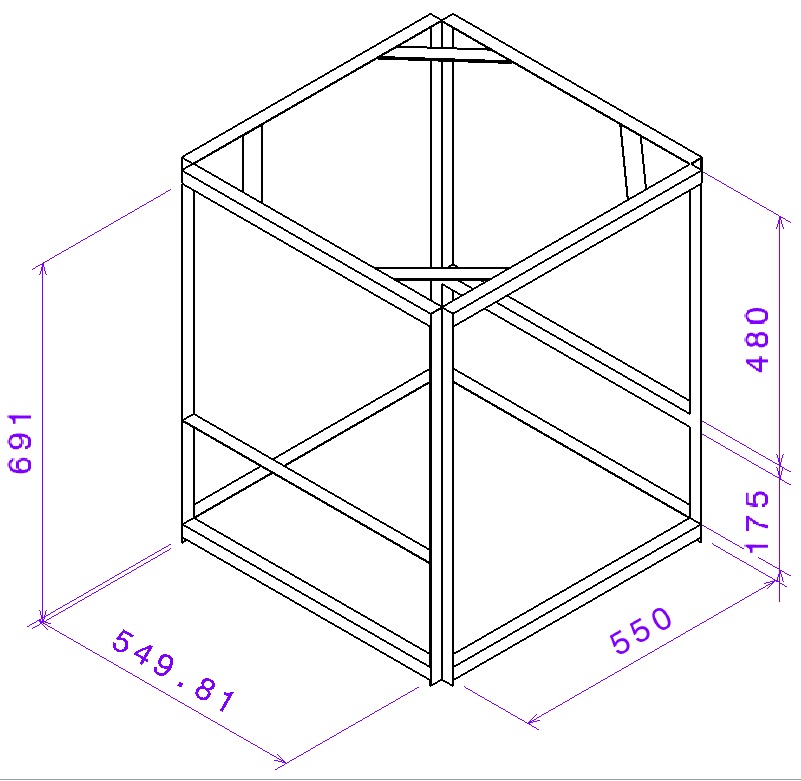
Estrutura/Imagens da Estrutura/Imagens de Softwares/draft1-chassi-cru.jpg
