PI2-Estufa/all-documents-PI2/Estrutura/Imagens da Estrutura/Imagens de Softwares/draft2-cantoneira-adicional.jpg

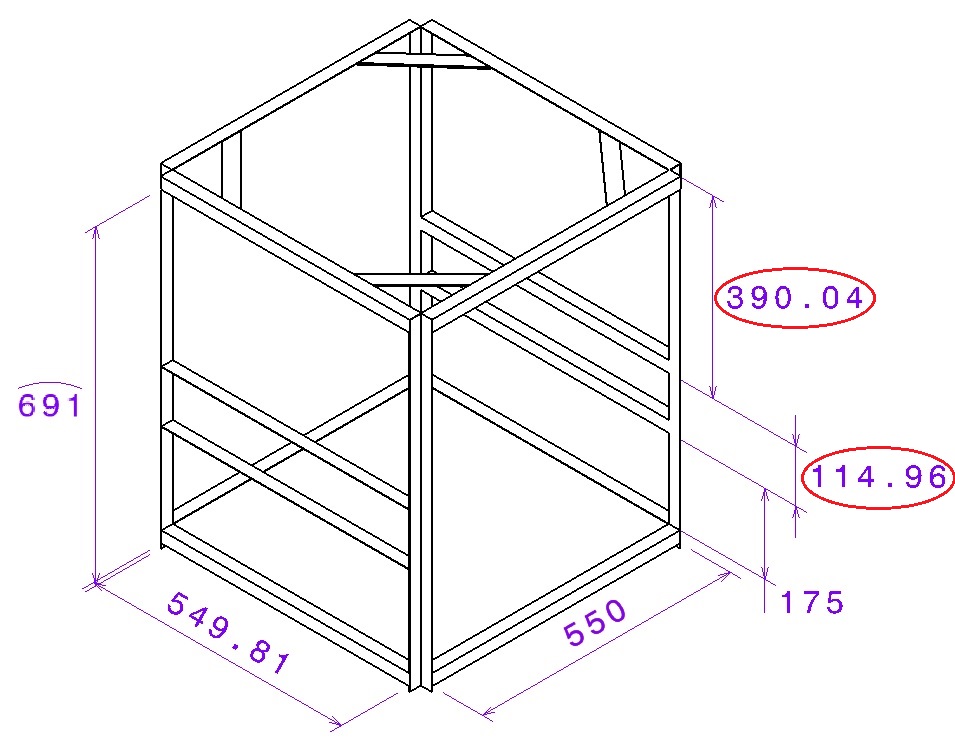
Estrutura/Imagens da Estrutura/Imagens de Softwares/draft2-cantoneira-adicional.jpg
