PI2-Estufa/all-documents-PI2/Estrutura/Imagens da Estrutura/Imagens de Softwares/draft3-assoalho.jpg

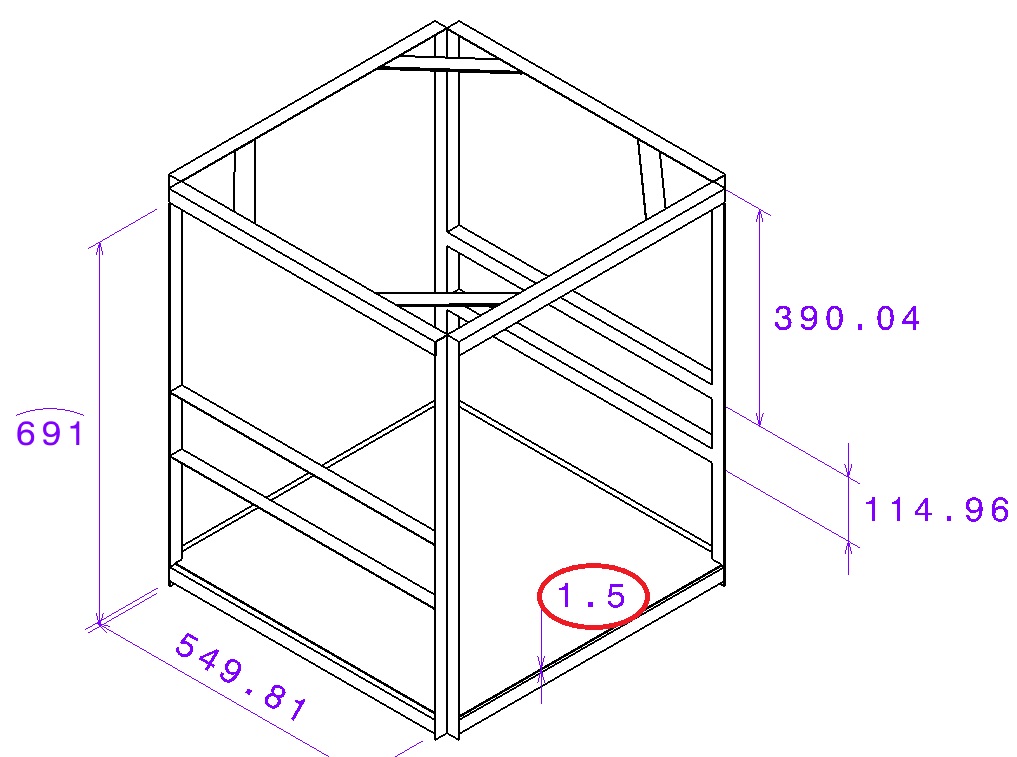
Estrutura/Imagens da Estrutura/Imagens de Softwares/draft3-assoalho.jpg
