PI2-Estufa/all-documents-PI2/Estrutura/Imagens da Estrutura/Imagens de Softwares/draft4-prateleira.jpg

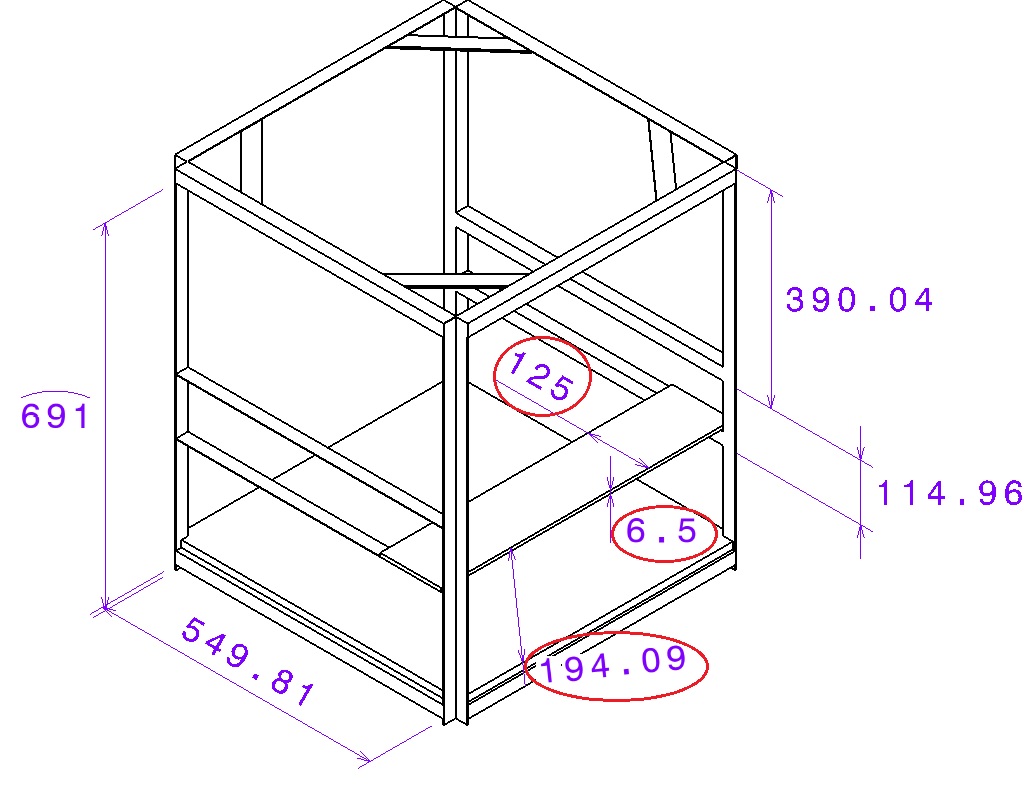
Estrutura/Imagens da Estrutura/Imagens de Softwares/draft4-prateleira.jpg
