PI2-Estufa/all-documents-PI2/Estrutura/Imagens da Estrutura/Imagens de Softwares/draft5-gaveta.jpg

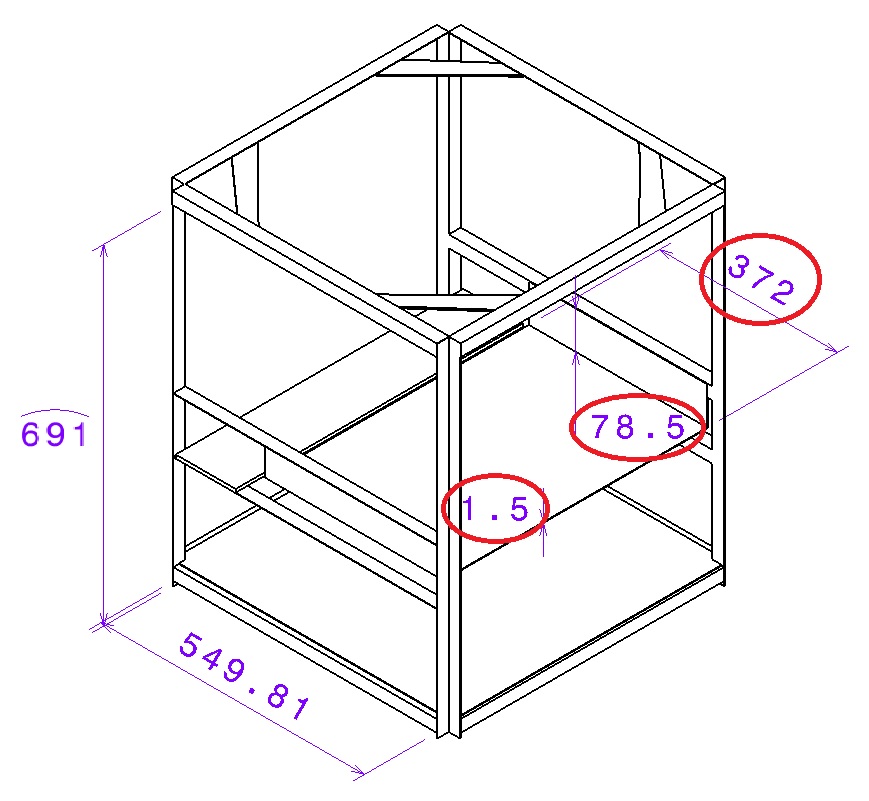
Estrutura/Imagens da Estrutura/Imagens de Softwares/draft5-gaveta.jpg
