PI2-Estufa/all-documents-PI2/Estrutura/Imagens da Estrutura/Imagens de Softwares/draft6-gaveta-prateleira-lateral.jpg

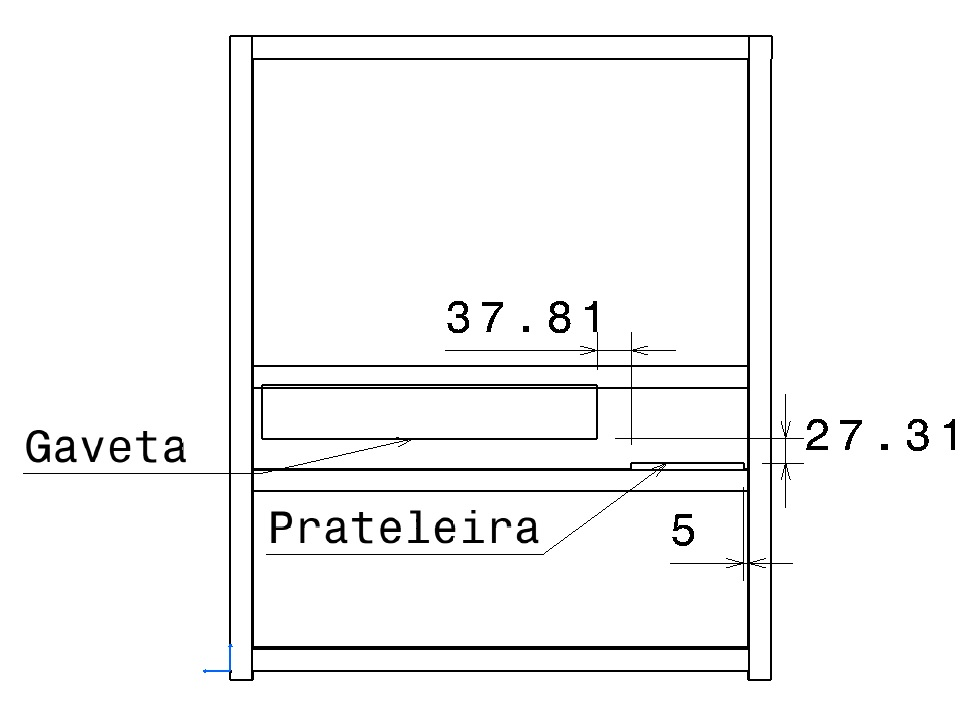
Estrutura/Imagens da Estrutura/Imagens de Softwares/draft6-gaveta-prateleira-lateral.jpg
