PI2-Estufa/all-documents-PI2/Estrutura/Imagens da Estrutura/Imagens de Softwares/draft7-lateral-area-de-trabalho.jpg

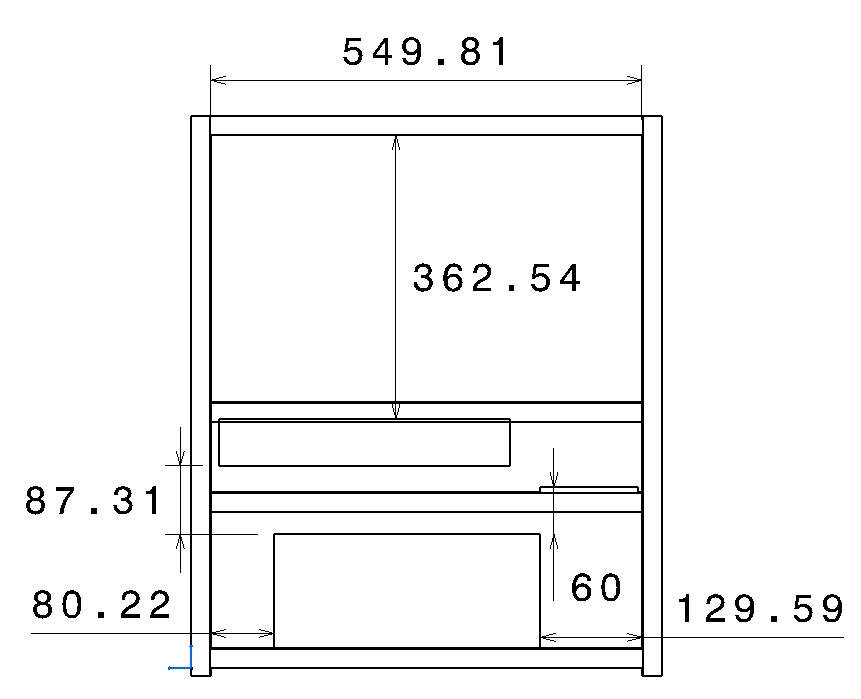
Estrutura/Imagens da Estrutura/Imagens de Softwares/draft7-lateral-area-de-trabalho.jpg
