PI2-Estufa/all-documents-PI2/Estrutura/Imagens da Estrutura/Imagens de Softwares/draft8-vista-frontal.jpg

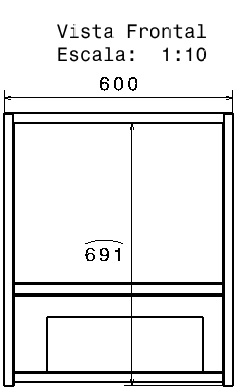
Estrutura/Imagens da Estrutura/Imagens de Softwares/draft8-vista-frontal.jpg
