PI2-Estufa/all-documents-PI2/Estrutura/Imagens da Estrutura/Imagens de Softwares/draft8-vistas gerais.jpg

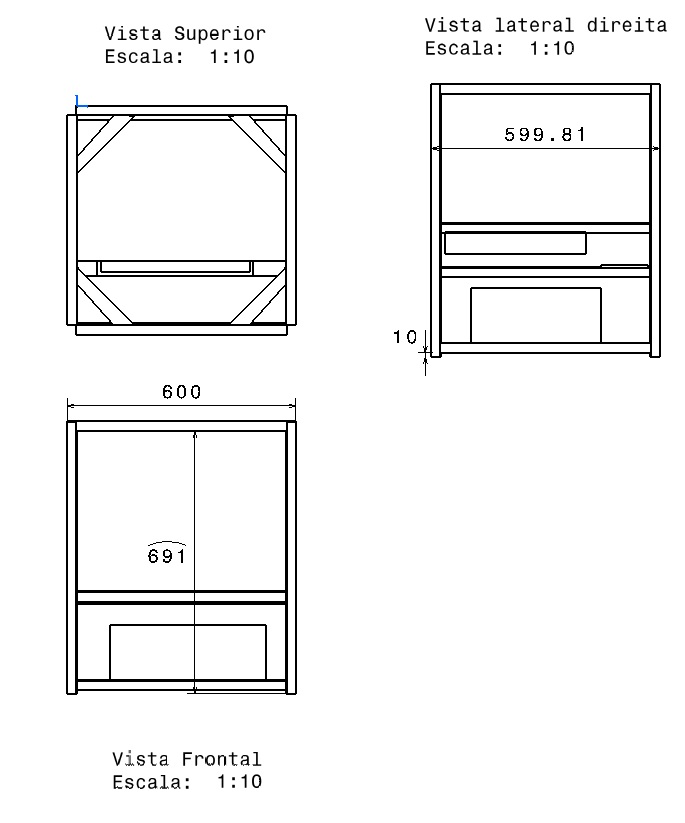
Estrutura/Imagens da Estrutura/Imagens de Softwares/draft8-vistas gerais.jpg
