PI2-Estufa/all-documents-PI2/Estrutura/Imagens da Estrutura/Imagens de Softwares/Estufa Renderizada.jpg

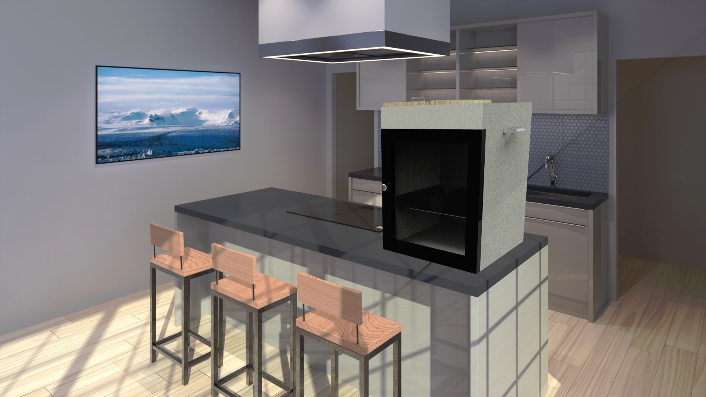
Estrutura/Imagens da Estrutura/Imagens de Softwares/Estufa Renderizada.jpg
