PI2-Estufa/all-documents-PI2/Estrutura/Imagens da Estrutura/Imagens de Softwares/estufarender.jpg

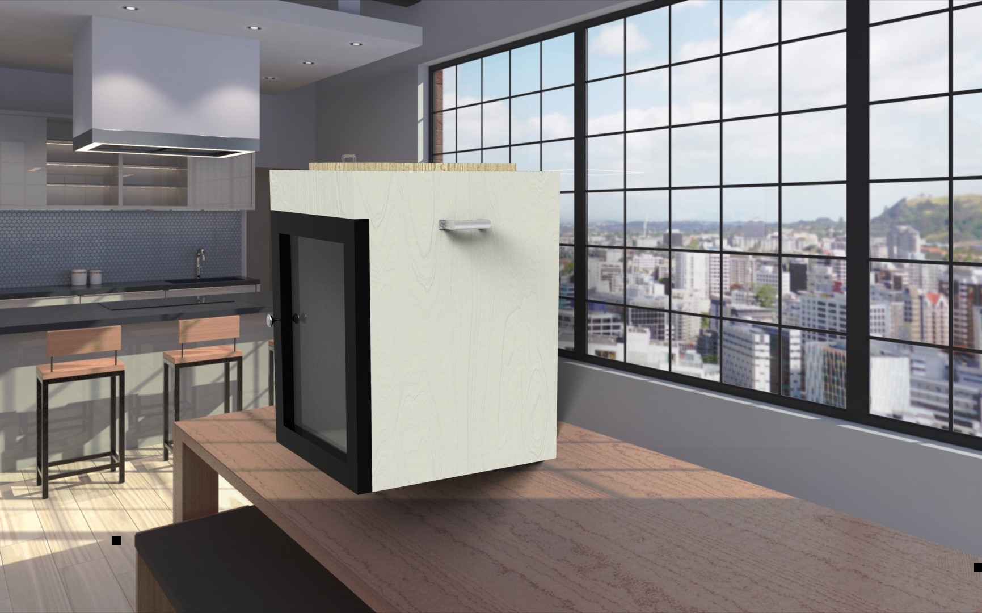
Estrutura/Imagens da Estrutura/Imagens de Softwares/estufarender.jpg
