PI2-Estufa/all-documents-PI2/Estrutura/Imagens da Estrutura/Imagens de Softwares/EstufaRF2.png

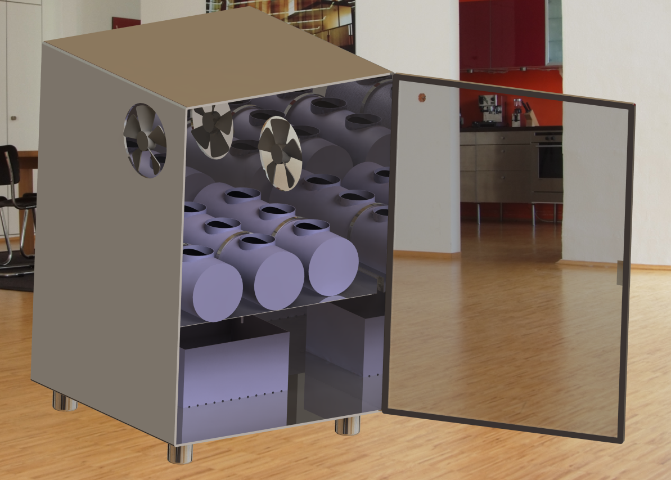
Estrutura/Imagens da Estrutura/Imagens de Softwares/EstufaRF2.png
