PI2-Estufa/all-documents-PI2/Fotos e vídeos/Fotos e vídeos/0E12FCA5-8868-4BF9-874D-3C982E2A47D0.jpg

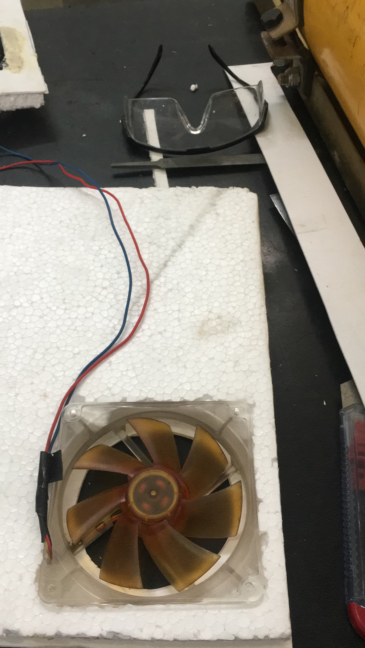
Fotos e vídeos/Fotos e vídeos/0E12FCA5-8868-4BF9-874D-3C982E2A47D0.jpg
