PI2-Estufa/all-documents-PI2/Fotos e vídeos/Fotos e vídeos/1F22B608-7059-4210-A510-513D19BD371F.jpg

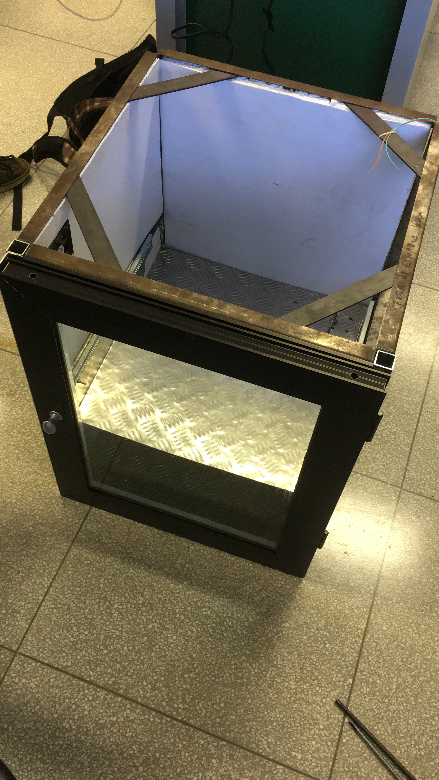
Fotos e vídeos/Fotos e vídeos/1F22B608-7059-4210-A510-513D19BD371F.jpg
