PI2-Estufa/all-documents-PI2/Fotos e vídeos/Fotos e vídeos/4A6DBDE6-FBE7-43C5-BFF1-CE5022DFC2A0.jpg

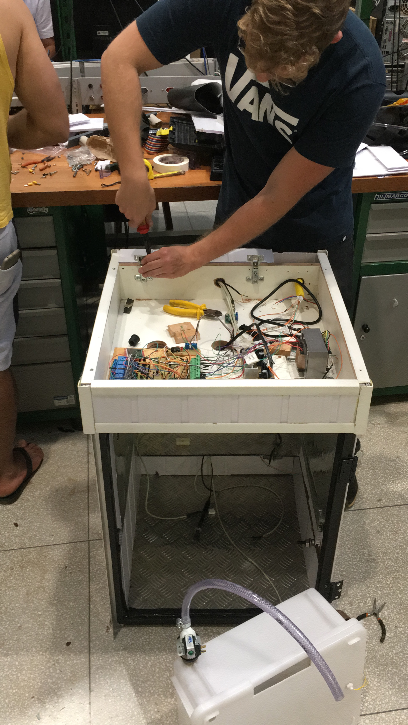
Fotos e vídeos/Fotos e vídeos/4A6DBDE6-FBE7-43C5-BFF1-CE5022DFC2A0.jpg
