PI2-Estufa/all-documents-PI2/Fotos e vídeos/Fotos e vídeos/4D9989BA-5210-42E2-A006-B1060A31A881.jpg

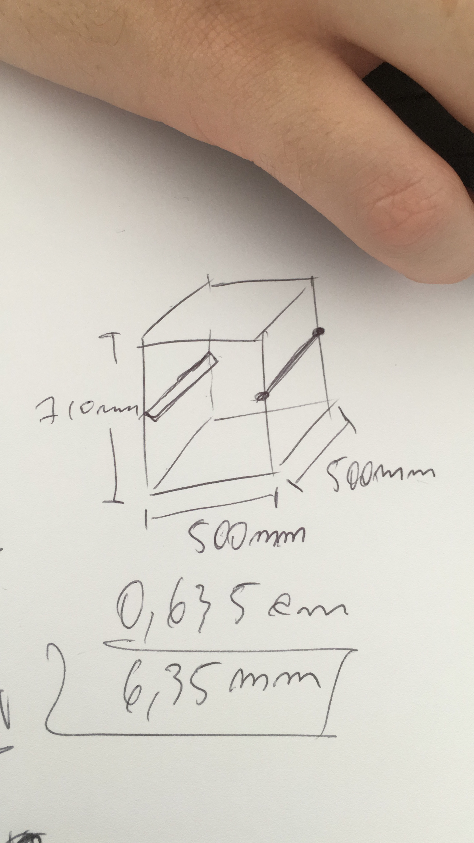
Fotos e vídeos/Fotos e vídeos/4D9989BA-5210-42E2-A006-B1060A31A881.jpg
