PI2-Estufa/all-documents-PI2/Fotos e vídeos/Fotos e vídeos/6F78D045-B21B-4655-9C48-4E3F0B7381E7.jpg

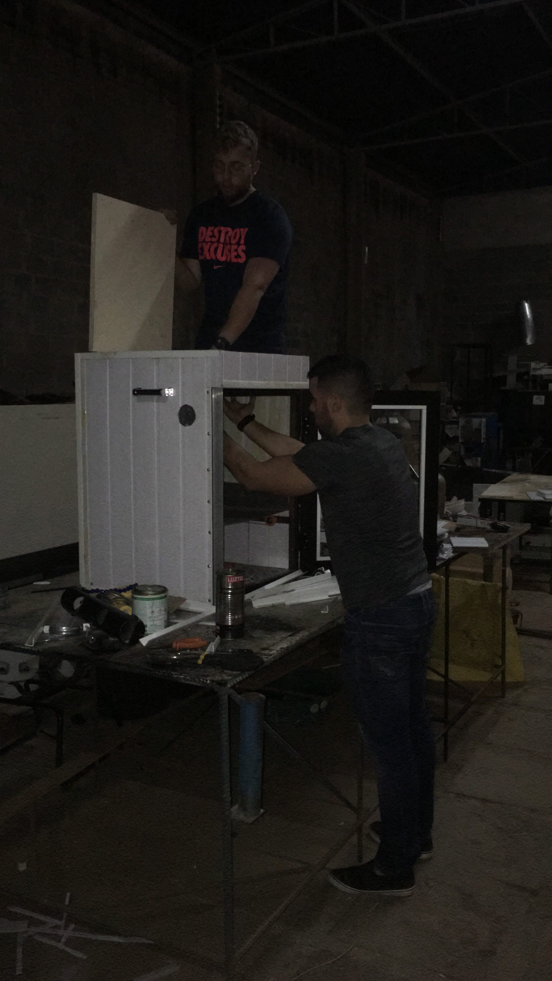
Fotos e vídeos/Fotos e vídeos/6F78D045-B21B-4655-9C48-4E3F0B7381E7.jpg
