PI2-Estufa/all-documents-PI2/Fotos e vídeos/Fotos e vídeos/7DF48790-DF64-4B9C-866E-3EF78731BEC4.jpg

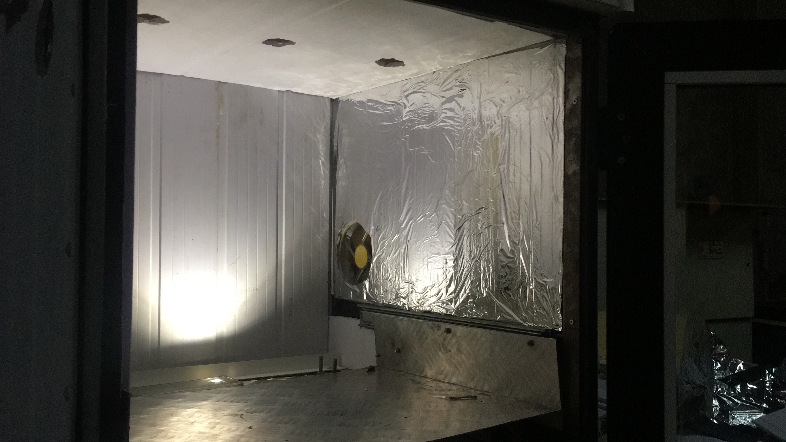
Fotos e vídeos/Fotos e vídeos/7DF48790-DF64-4B9C-866E-3EF78731BEC4.jpg
