PI2-Estufa/all-documents-PI2/Fotos e vídeos/Fotos e vídeos/8E35A5E5-FADF-4F50-9B56-730C862851F3.jpg

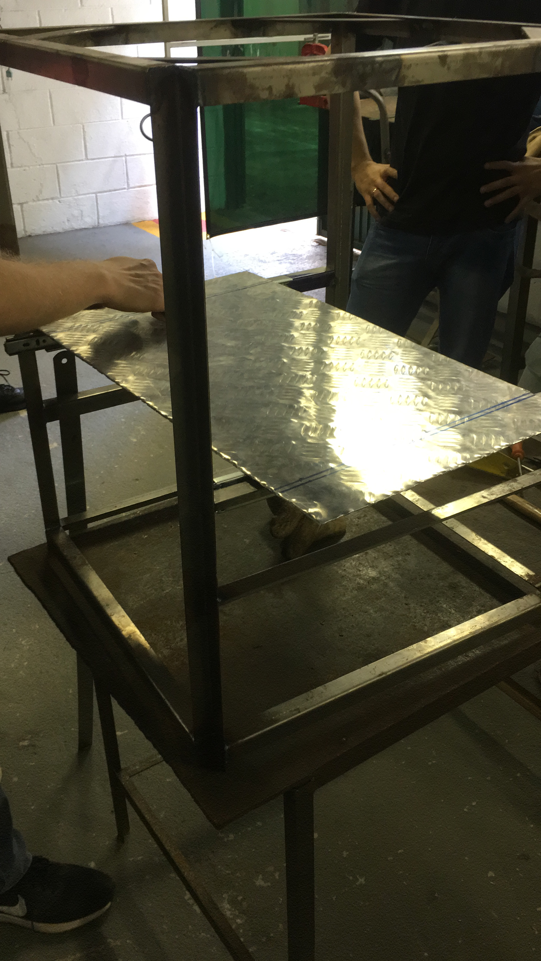
Fotos e vídeos/Fotos e vídeos/8E35A5E5-FADF-4F50-9B56-730C862851F3.jpg
