PI2-Estufa/all-documents-PI2/Fotos e vídeos/Fotos e vídeos/031DD9E5-9553-4144-AFDD-5B50952EB1ED.jpg

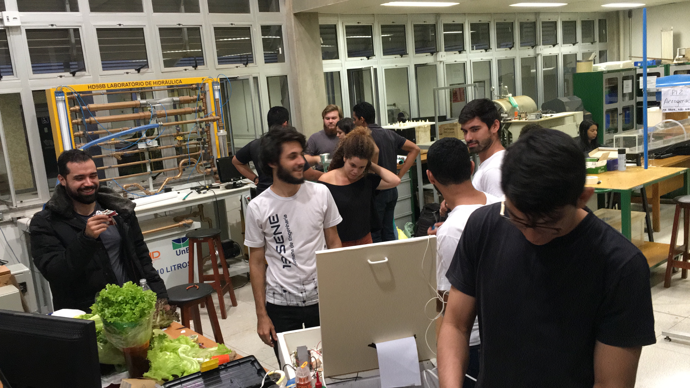
Fotos e vídeos/Fotos e vídeos/031DD9E5-9553-4144-AFDD-5B50952EB1ED.jpg
