PI2-Estufa/all-documents-PI2/Fotos e vídeos/Fotos e vídeos/0047A992-1583-4D32-9E8F-200BB6969080.jpg

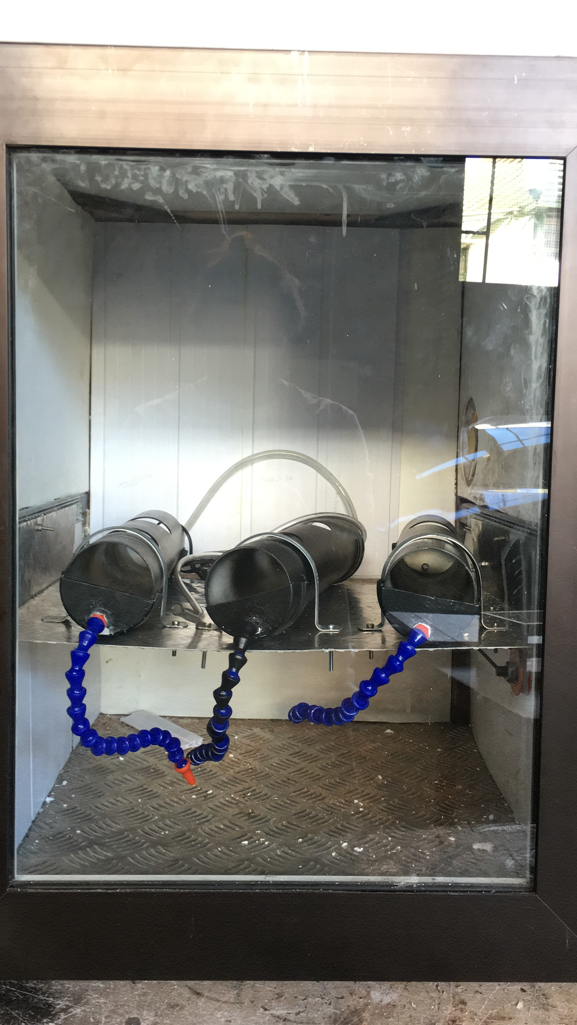
Fotos e vídeos/Fotos e vídeos/0047A992-1583-4D32-9E8F-200BB6969080.jpg
