PI2-Estufa/all-documents-PI2/Fotos e vídeos/Fotos e vídeos/68D1D101-F056-4CDE-8964-33569C9737F8.jpg

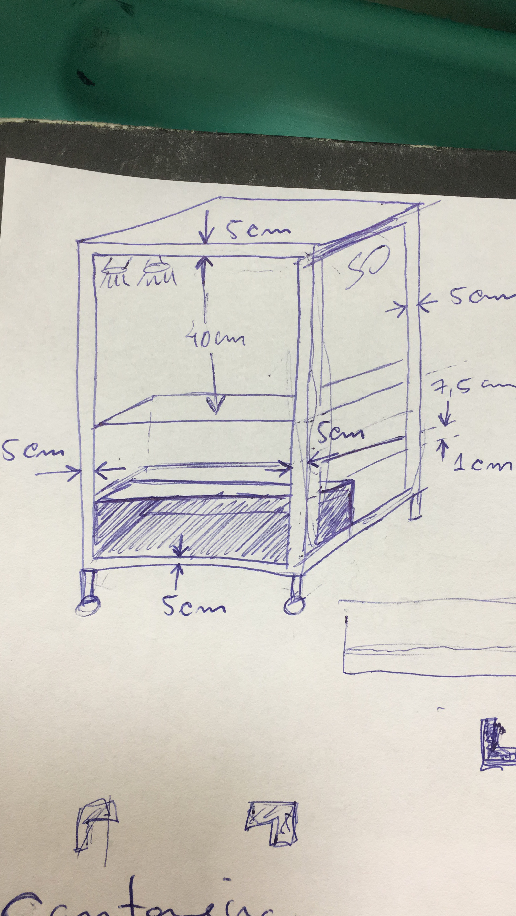
Fotos e vídeos/Fotos e vídeos/68D1D101-F056-4CDE-8964-33569C9737F8.jpg
