PI2-Estufa/all-documents-PI2/Fotos e vídeos/Fotos e vídeos/77A58E4B-AC12-460F-8CE2-467A493D1600.jpg

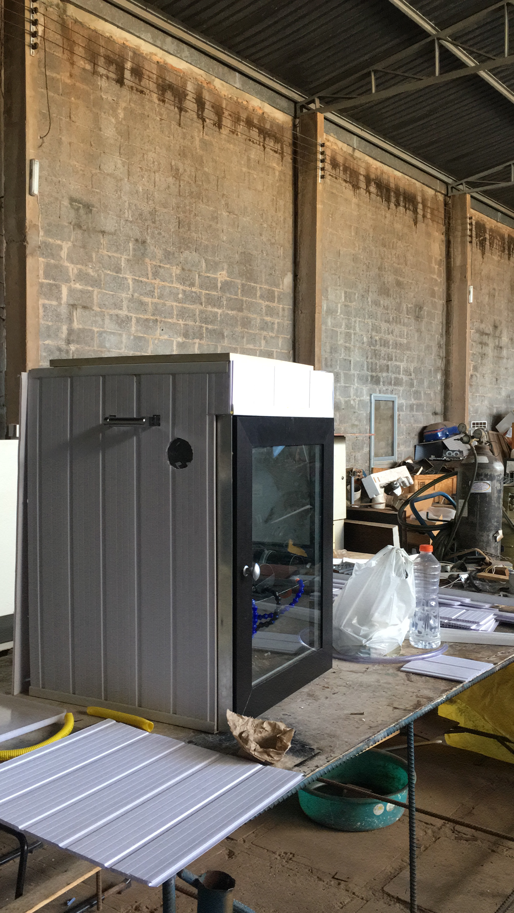
Fotos e vídeos/Fotos e vídeos/77A58E4B-AC12-460F-8CE2-467A493D1600.jpg
