PI2-Estufa/all-documents-PI2/Fotos e vídeos/Fotos e vídeos/078A5C19-B125-4099-B504-9FFBEB329357.jpg

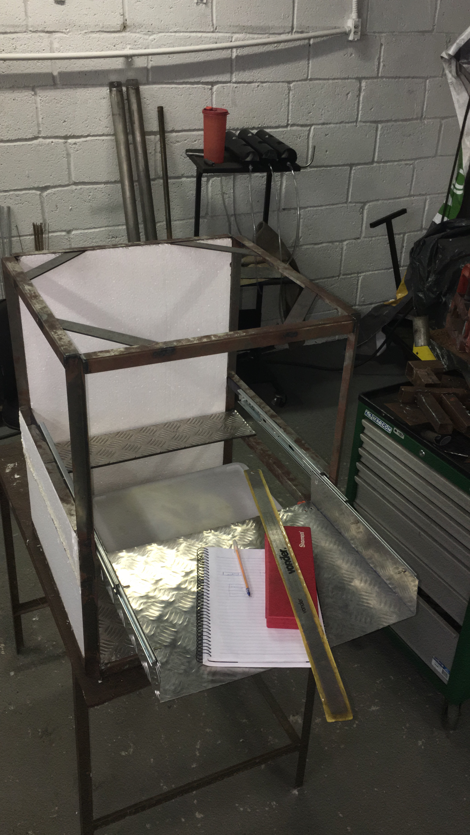
Fotos e vídeos/Fotos e vídeos/078A5C19-B125-4099-B504-9FFBEB329357.jpg
