PI2-Estufa/all-documents-PI2/Fotos e vídeos/Fotos e vídeos/87A1E01D-0493-449B-B79E-47F00914E589.jpg

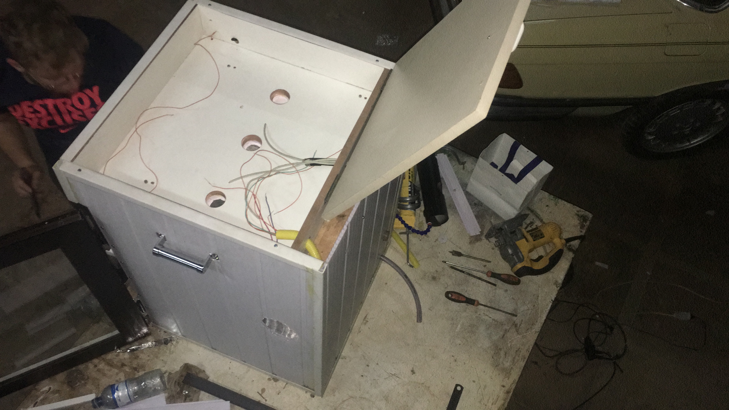
Fotos e vídeos/Fotos e vídeos/87A1E01D-0493-449B-B79E-47F00914E589.jpg
