PI2-Estufa/all-documents-PI2/Fotos e vídeos/Fotos e vídeos/96BCC7E4-1279-4806-B085-58CDF0AA8602.jpg

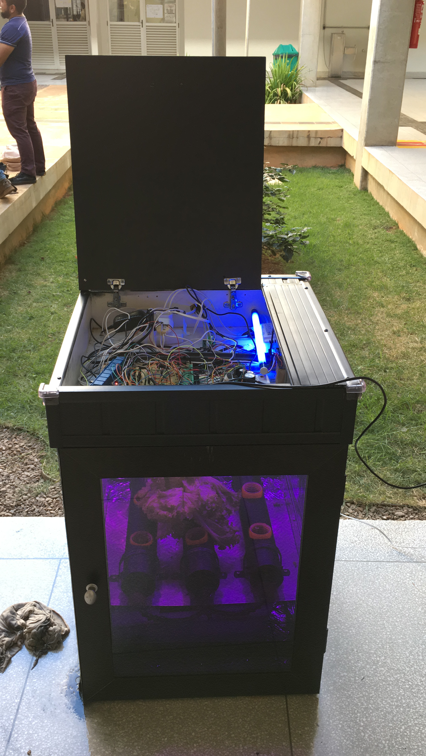
Fotos e vídeos/Fotos e vídeos/96BCC7E4-1279-4806-B085-58CDF0AA8602.jpg
