PI2-Estufa/all-documents-PI2/Fotos e vídeos/Fotos e vídeos/159e1861-7c79-4576-9b49-d67a5e7ab45c.jpg

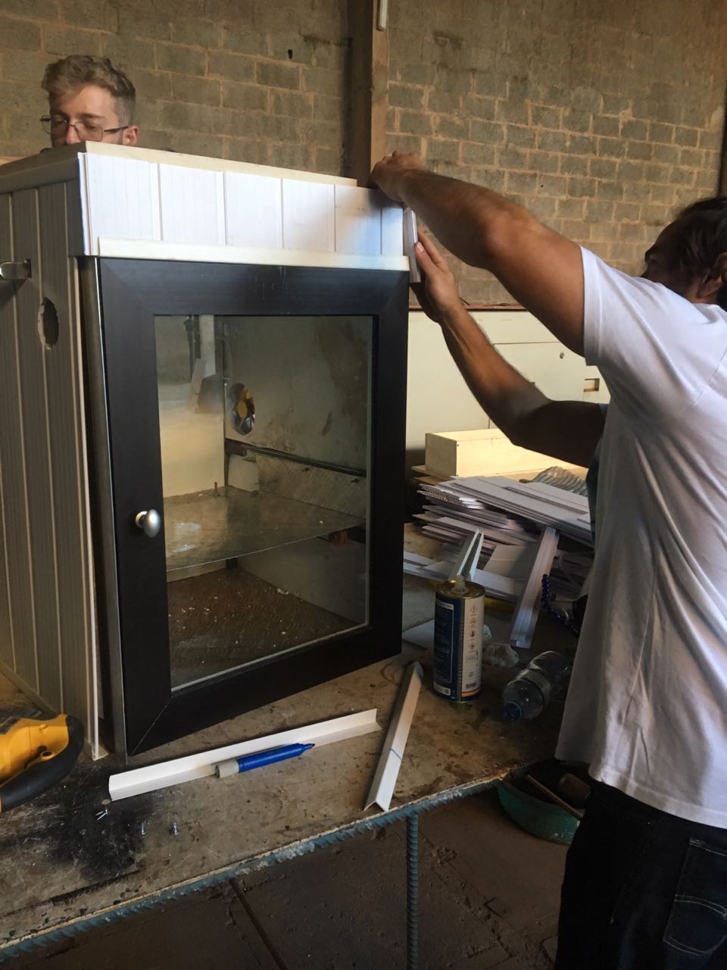
Fotos e vídeos/Fotos e vídeos/159e1861-7c79-4576-9b49-d67a5e7ab45c.jpg
