PI2-Estufa/all-documents-PI2/Fotos e vídeos/Fotos e vídeos/287C26B6-CF08-45F1-A2BA-FE4691D4CDF7.jpg

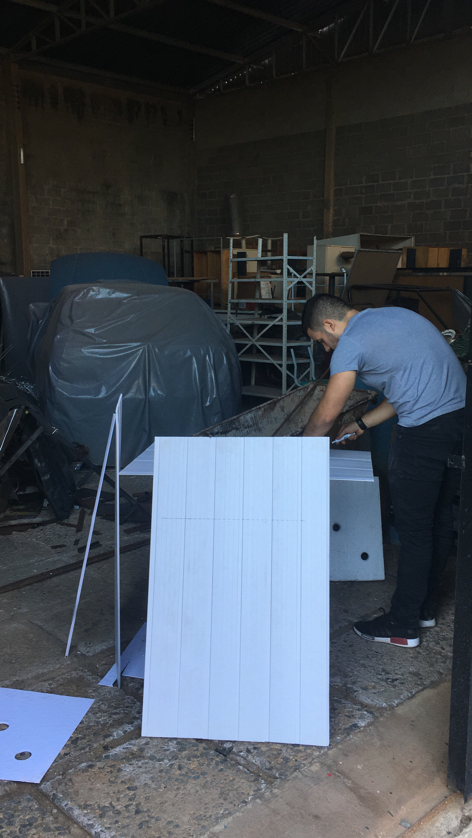
Fotos e vídeos/Fotos e vídeos/287C26B6-CF08-45F1-A2BA-FE4691D4CDF7.jpg
