PI2-Estufa/all-documents-PI2/Fotos e vídeos/Fotos e vídeos/353b26b4-7edc-44c6-856f-a54eef89e5ca.jpg

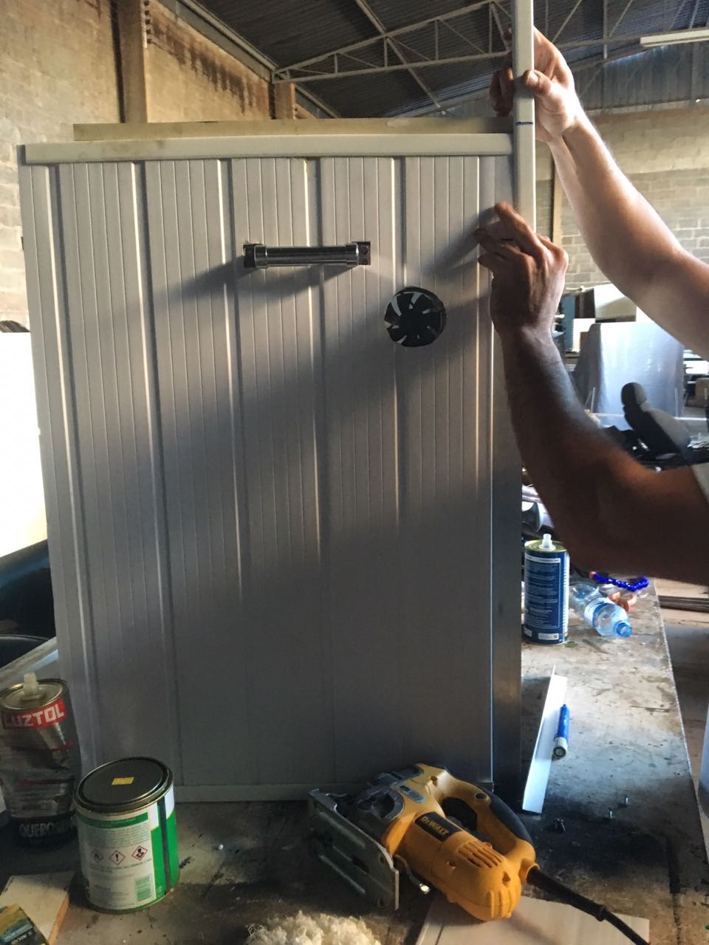
Fotos e vídeos/Fotos e vídeos/353b26b4-7edc-44c6-856f-a54eef89e5ca.jpg
