PI2-Estufa/all-documents-PI2/Fotos e vídeos/Fotos e vídeos/592D3542-0443-42D0-8818-B00612704C12.jpg

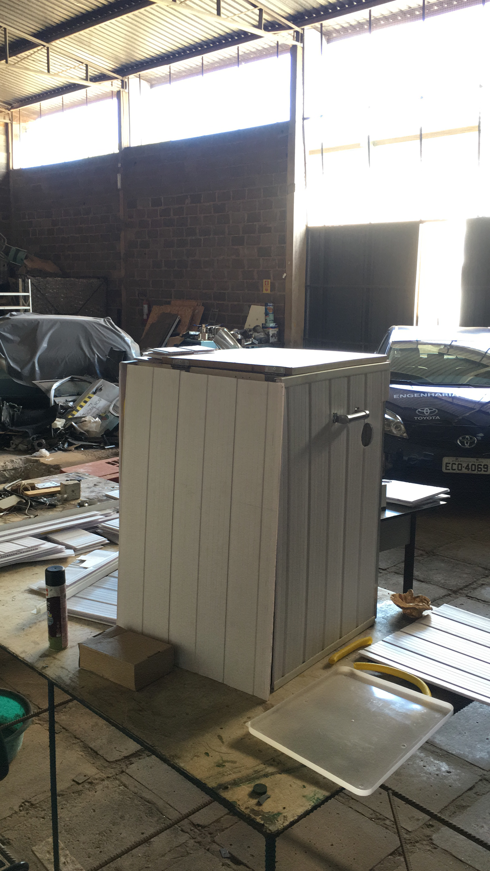
Fotos e vídeos/Fotos e vídeos/592D3542-0443-42D0-8818-B00612704C12.jpg
