PI2-Estufa/all-documents-PI2/Fotos e vídeos/Fotos e vídeos/713C55DC-1784-411B-8067-3F4DE09B7301.jpg

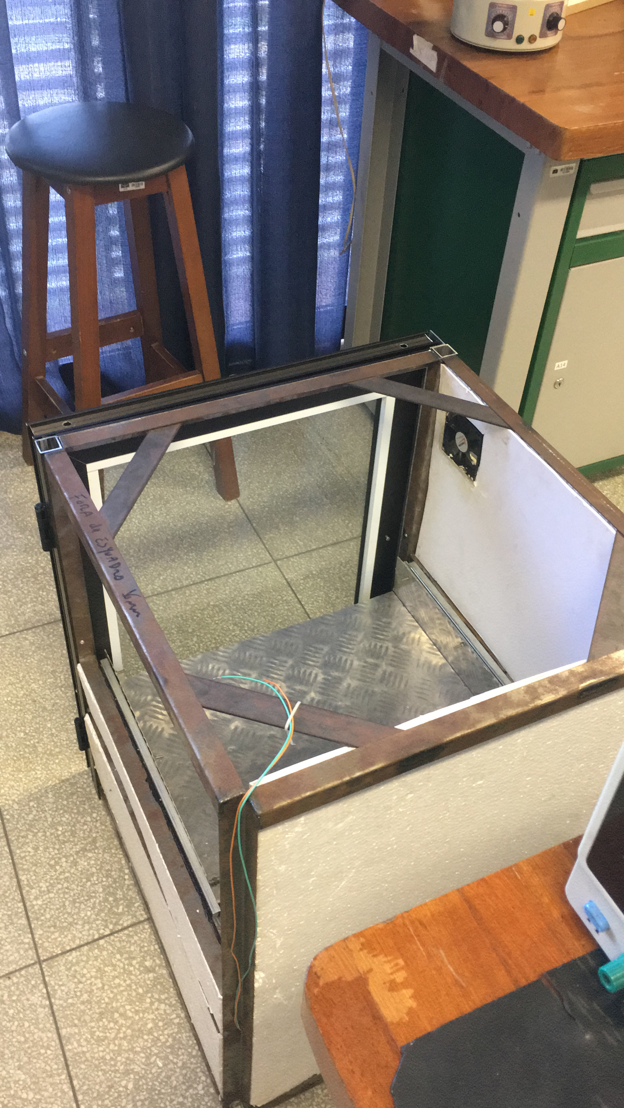
Fotos e vídeos/Fotos e vídeos/713C55DC-1784-411B-8067-3F4DE09B7301.jpg
