PI2-Estufa/all-documents-PI2/Fotos e vídeos/Fotos e vídeos/03879F2D-D607-4942-BE4A-E539B641DE2D.jpg

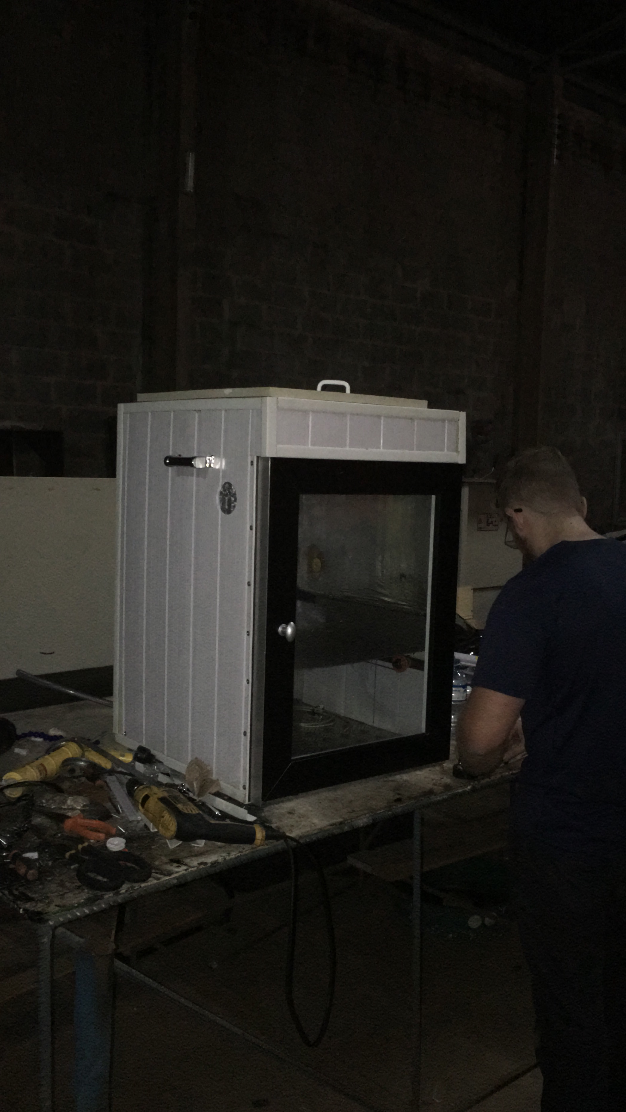
Fotos e vídeos/Fotos e vídeos/03879F2D-D607-4942-BE4A-E539B641DE2D.jpg
