PI2-Estufa/all-documents-PI2/Fotos e vídeos/Fotos e vídeos/4734A661-6C11-47B1-B1D8-C41BFF4C8E3E.jpg

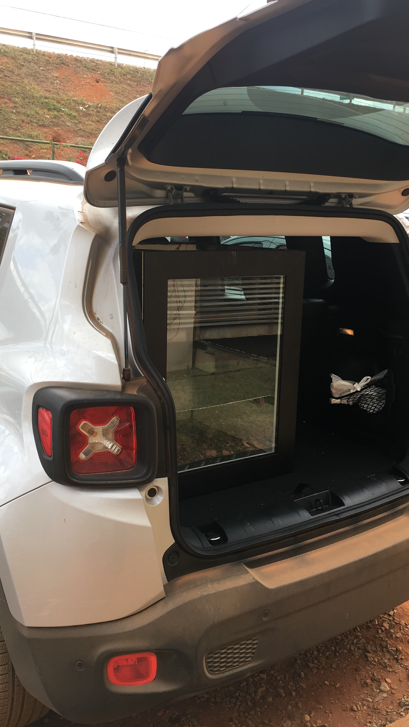
Fotos e vídeos/Fotos e vídeos/4734A661-6C11-47B1-B1D8-C41BFF4C8E3E.jpg
