PI2-Estufa/all-documents-PI2/Fotos e vídeos/Fotos e vídeos/17951A3B-1AC0-4B41-8A64-7706E06D864B.jpg

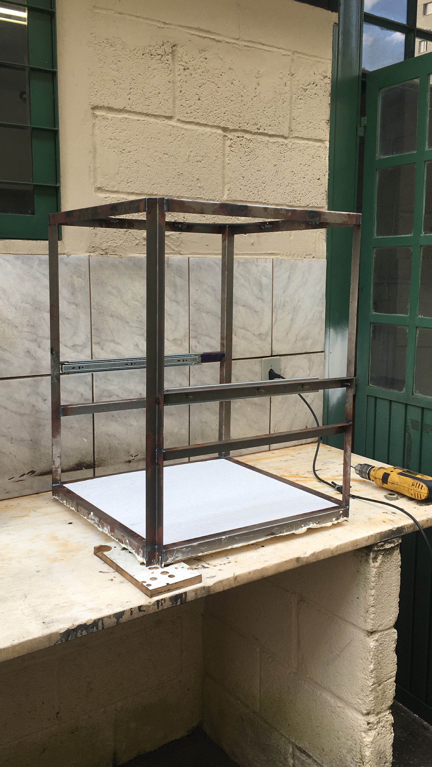
Fotos e vídeos/Fotos e vídeos/17951A3B-1AC0-4B41-8A64-7706E06D864B.jpg
