PI2-Estufa/all-documents-PI2/Fotos e vídeos/Fotos e vídeos/30303E9C-C0A8-447B-8625-7EB1E29E185E.jpg

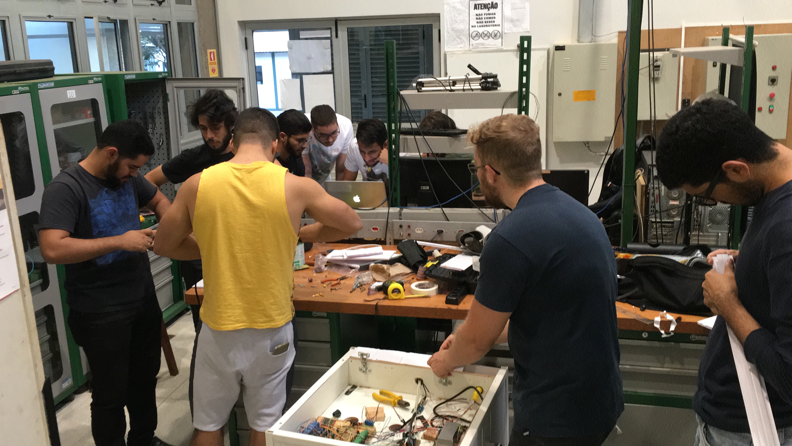
Fotos e vídeos/Fotos e vídeos/30303E9C-C0A8-447B-8625-7EB1E29E185E.jpg
