PI2-Estufa/all-documents-PI2/Fotos e vídeos/Fotos e vídeos/4063315C-5530-4CDE-9623-C5F5FE1649B6.jpg

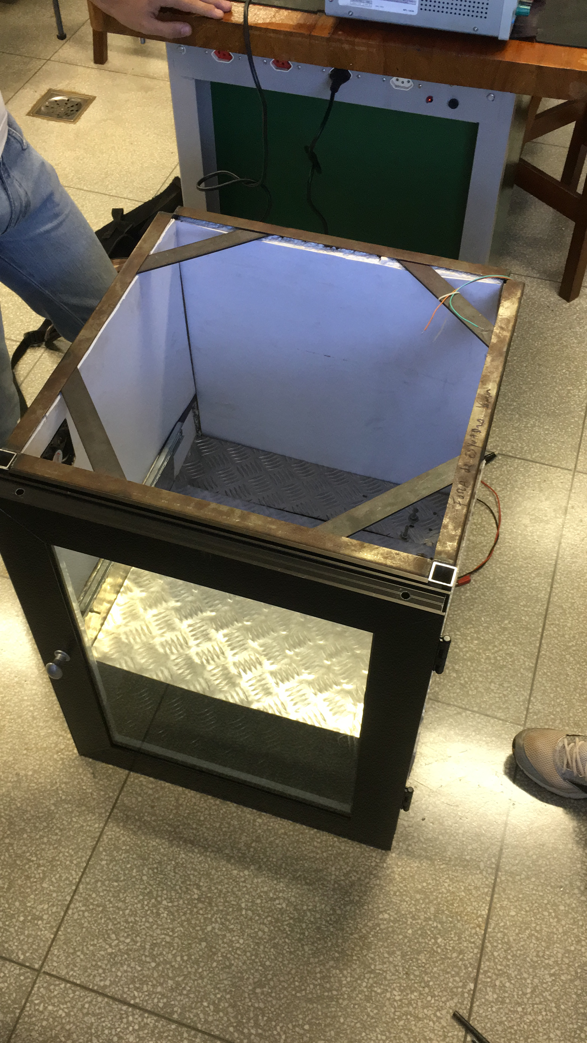
Fotos e vídeos/Fotos e vídeos/4063315C-5530-4CDE-9623-C5F5FE1649B6.jpg
