PI2-Estufa/all-documents-PI2/Fotos e vídeos/Fotos e vídeos/a5be44f7-b1d4-415a-9508-cad8d5f6b0b1.jpg

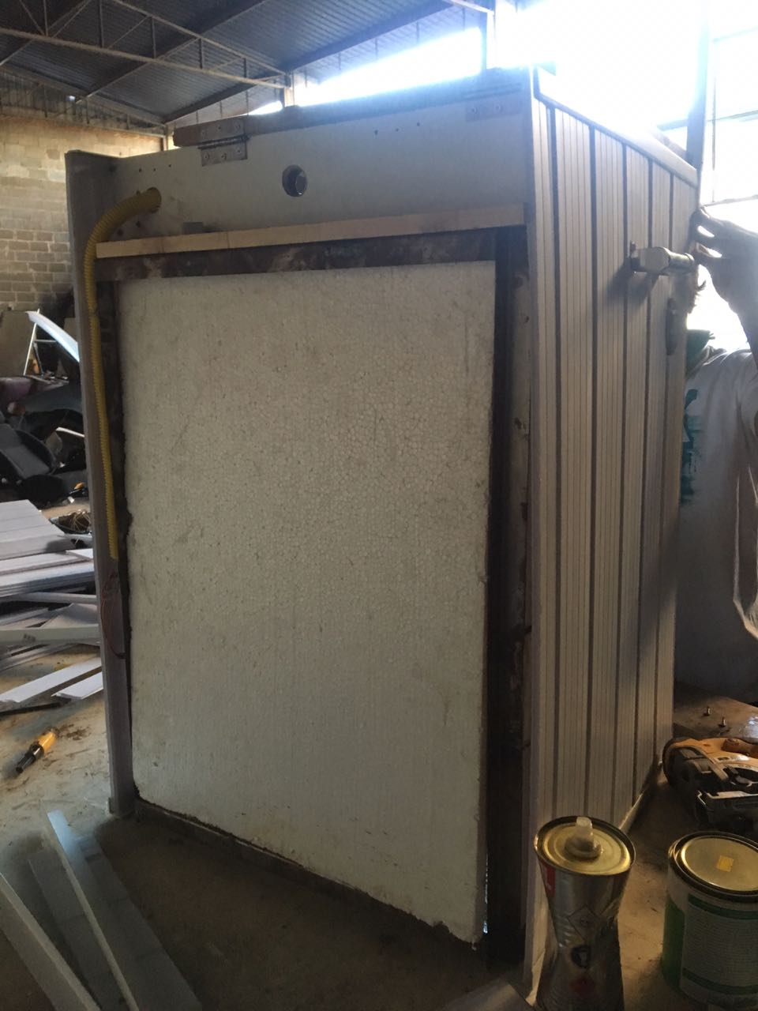
Fotos e vídeos/Fotos e vídeos/a5be44f7-b1d4-415a-9508-cad8d5f6b0b1.jpg
