PI2-Estufa/all-documents-PI2/Fotos e vídeos/Fotos e vídeos/B1AE1C09-07FF-4BA6-A42C-36F70ACE713C.jpg

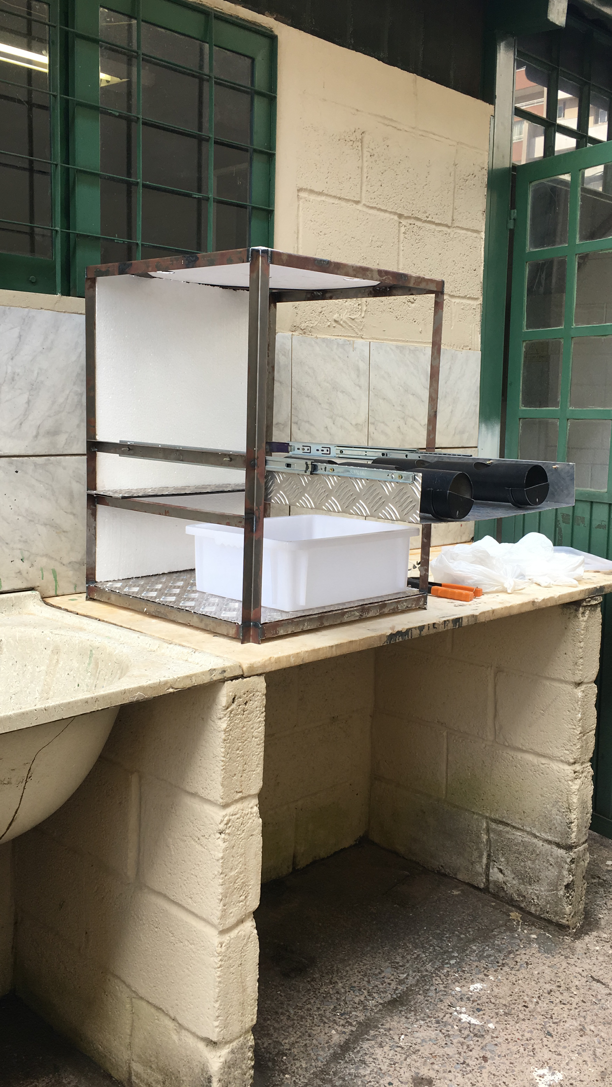
Fotos e vídeos/Fotos e vídeos/B1AE1C09-07FF-4BA6-A42C-36F70ACE713C.jpg
