PI2-Estufa/all-documents-PI2/Fotos e vídeos/Fotos e vídeos/BAA2D213-6E6D-446B-B353-D3347601BCD8.jpg

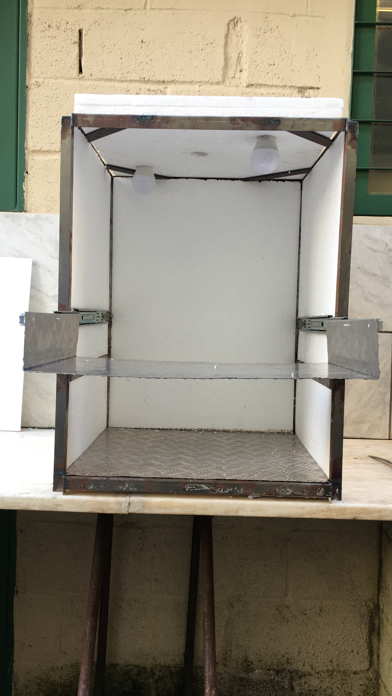
Fotos e vídeos/Fotos e vídeos/BAA2D213-6E6D-446B-B353-D3347601BCD8.jpg
