PI2-Estufa/all-documents-PI2/Fotos e vídeos/Fotos e vídeos/C6722503-CBBB-408D-9314-F8185867CE43.jpg

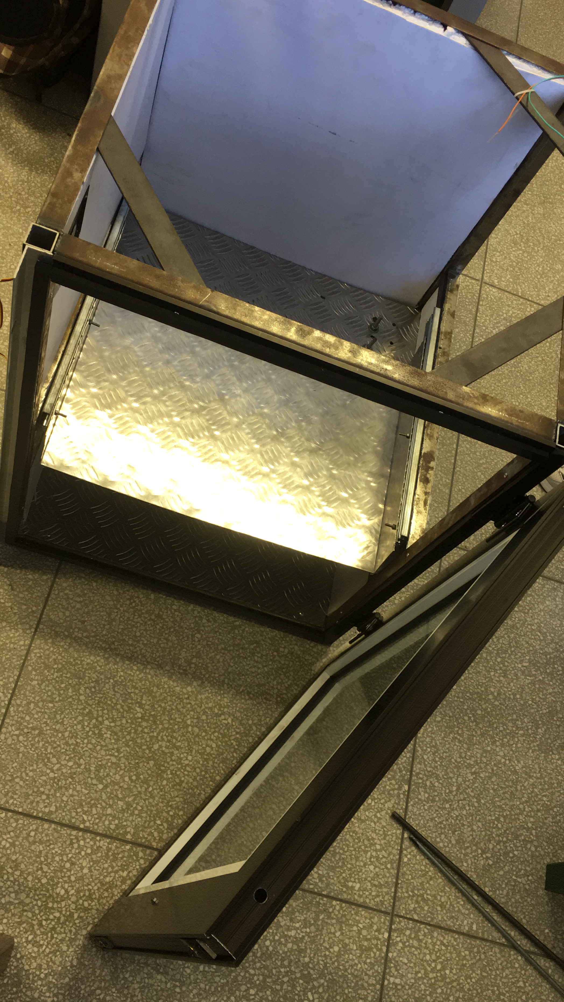
Fotos e vídeos/Fotos e vídeos/C6722503-CBBB-408D-9314-F8185867CE43.jpg
