PI2-Estufa/all-documents-PI2/Fotos e vídeos/Fotos e vídeos/CA9336FC-85F8-4E18-A48B-B875283CC69C.jpg

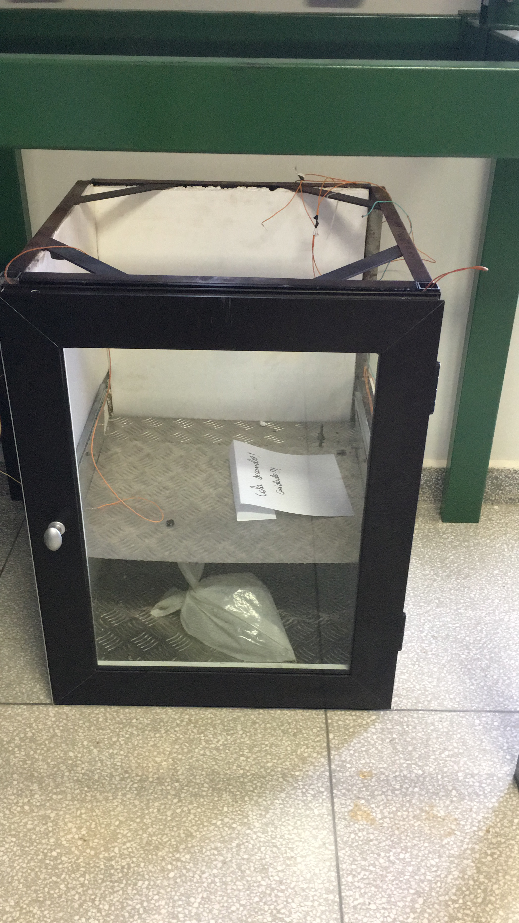
Fotos e vídeos/Fotos e vídeos/CA9336FC-85F8-4E18-A48B-B875283CC69C.jpg
