PI2-Estufa/all-documents-PI2/Fotos e vídeos/Fotos e vídeos/camphoto_1903590565.jpg

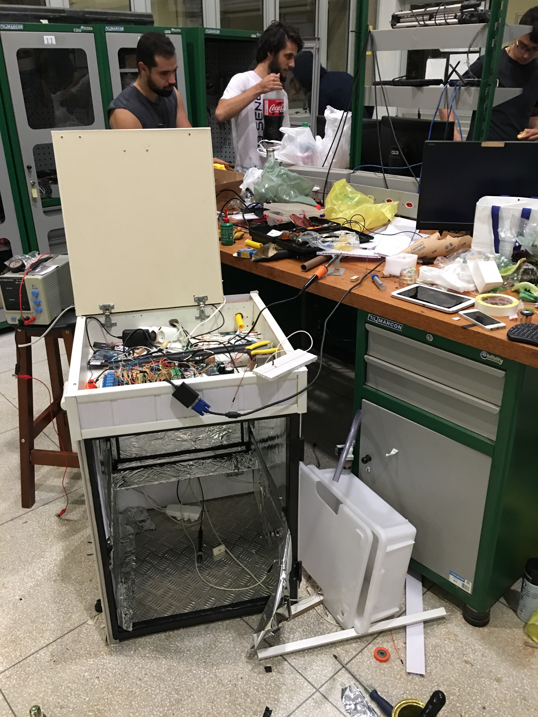
Fotos e vídeos/Fotos e vídeos/camphoto_1903590565.jpg
