PI2-Estufa/all-documents-PI2/Fotos e vídeos/Fotos e vídeos/D3CD3BA1-B6D6-45F7-AB2C-D3724B5B9F4D.jpg

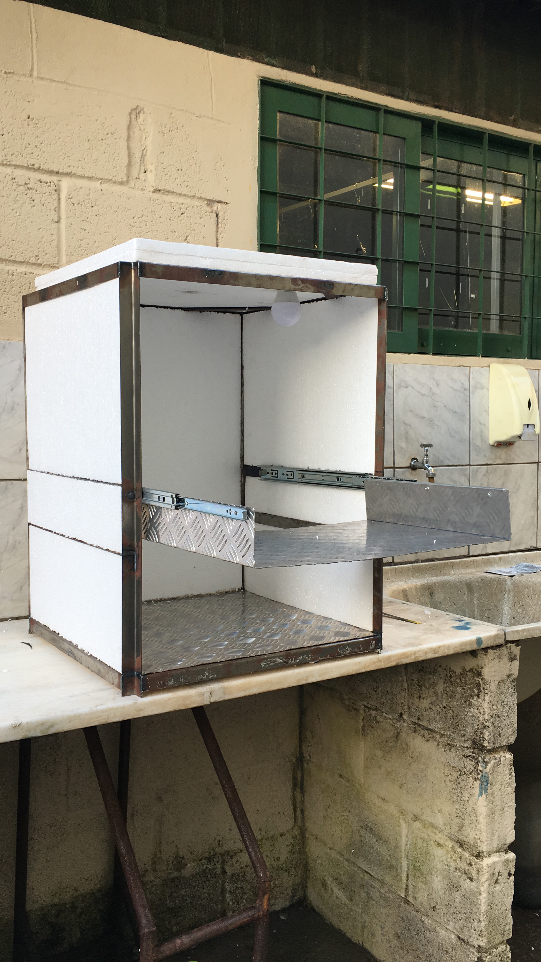
Fotos e vídeos/Fotos e vídeos/D3CD3BA1-B6D6-45F7-AB2C-D3724B5B9F4D.jpg
