PI2-Estufa/all-documents-PI2/Fotos e vídeos/Fotos e vídeos/d464a652-0b8d-4425-99fd-81fb4d007250.jpg

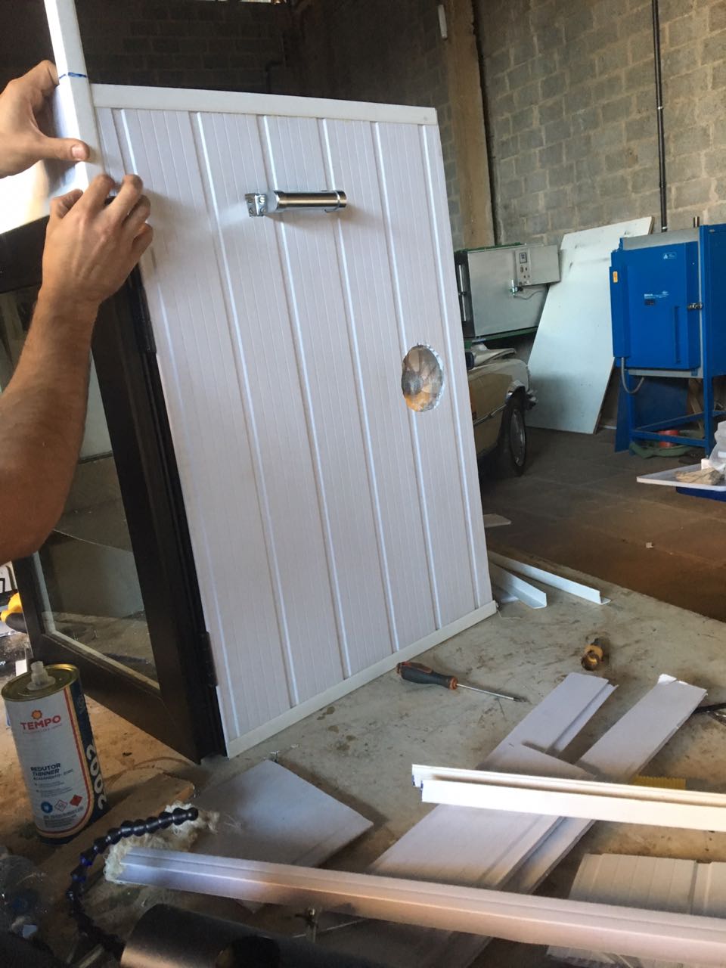
Fotos e vídeos/Fotos e vídeos/d464a652-0b8d-4425-99fd-81fb4d007250.jpg
