PI2-Estufa/all-documents-PI2/Fotos e vídeos/Fotos e vídeos/DE3722E5-1288-4C03-A187-29399CA2D426.jpg

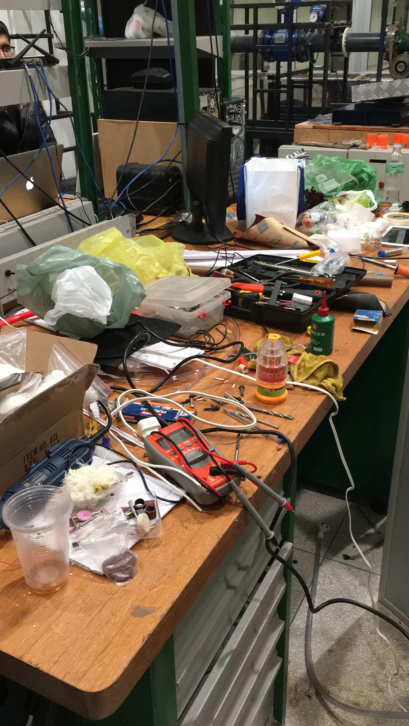
Fotos e vídeos/Fotos e vídeos/DE3722E5-1288-4C03-A187-29399CA2D426.jpg
