PI2-Estufa/all-documents-PI2/Fotos e vídeos/Fotos e vídeos/E3DD18CF-BB14-4991-AF88-B77D8ABA9589.jpg

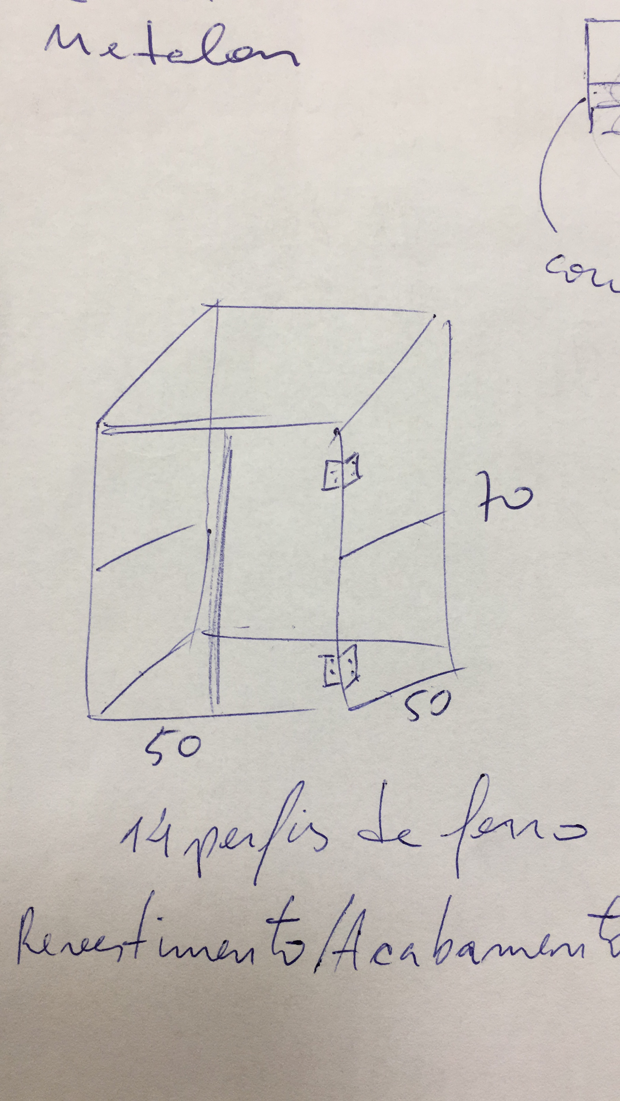
Fotos e vídeos/Fotos e vídeos/E3DD18CF-BB14-4991-AF88-B77D8ABA9589.jpg
