PI2-Estufa/all-documents-PI2/Fotos e vídeos/Fotos e vídeos/Image uploaded from iOS.jpg

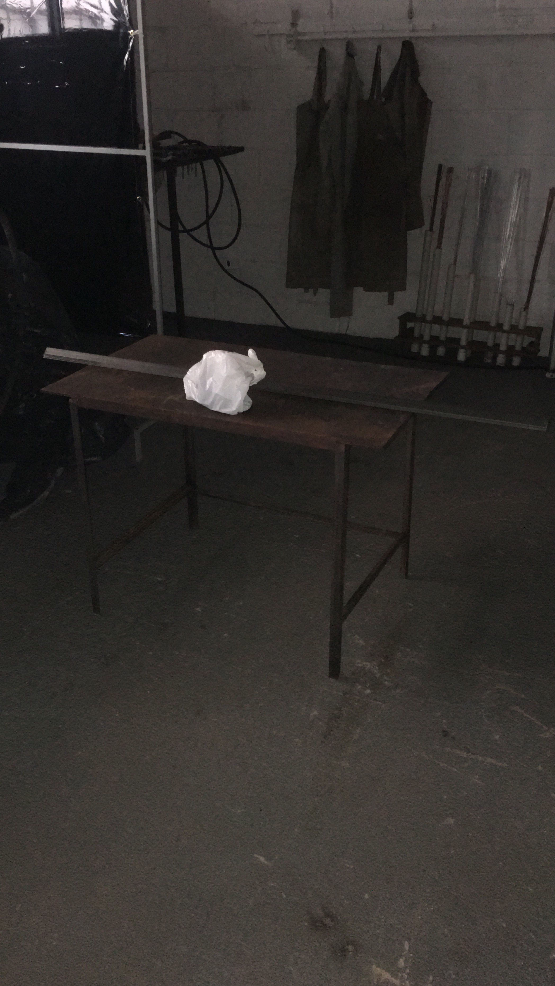
Fotos e vídeos/Fotos e vídeos/Image uploaded from iOS.jpg
