PI2-Estufa/all-documents-PI2/Fotos e vídeos/Fotos e vídeos/IMG_4012.JPG

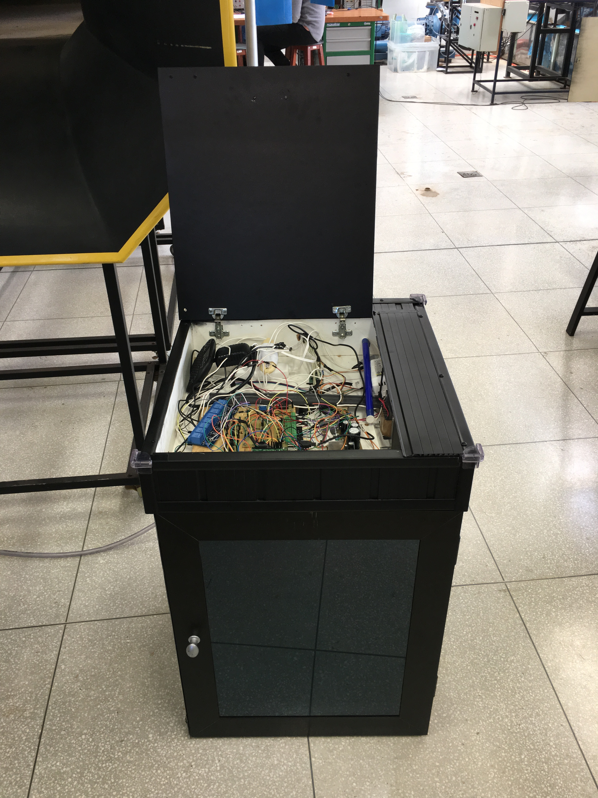
Fotos e vídeos/Fotos e vídeos/IMG_4012.JPG
