PI2-Estufa/all-documents-PI2/Fotos e vídeos/Fotos e vídeos/WhatsApp Image 2018-06-14 at 18.19.46.jpeg

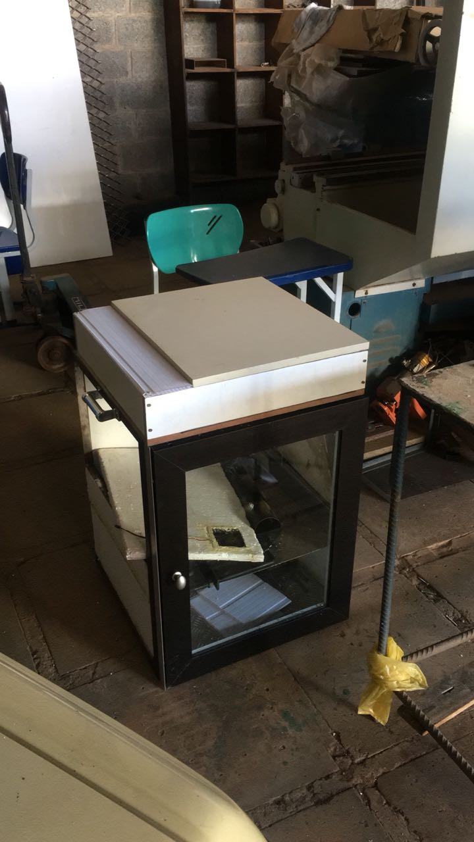
Fotos e vídeos/Fotos e vídeos/WhatsApp Image 2018-06-14 at 18.19.46.jpeg
