PI2-Estufa/all-documents-PI2/Fotos e vídeos/Fotos e vídeos/WhatsApp Image 2018-06-20 at 21.29.12.jpeg

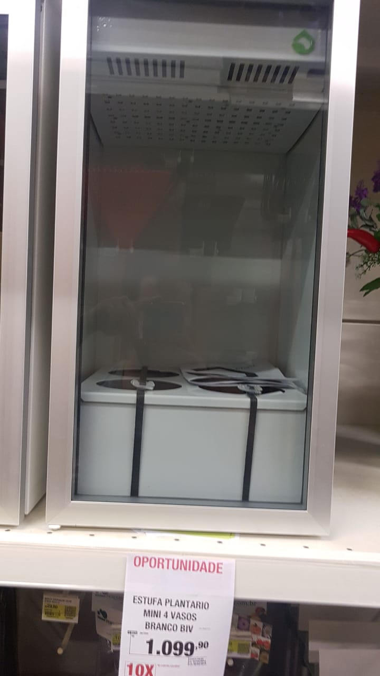
Fotos e vídeos/Fotos e vídeos/WhatsApp Image 2018-06-20 at 21.29.12.jpeg
