PI2-Estufa/all-documents-PI2/(list of files, cad)

Other CAD files:
Estrutura/CADs de Estrutura/Chassi-Estufa-atualizado.CATPart
Estrutura/CADs de Estrutura/Product1.CATProduct
Estrutura/CADs de Estrutura/bandeja.CATPart
Estrutura/CADs de Estrutura/bracadeira1.CATPart
Estrutura/CADs de Estrutura/cano.CATPart
Estrutura/CADs de Estrutura/cassi3.CATPart
Estrutura/CADs de Estrutura/chassi.CATPart
Estrutura/CADs de Estrutura/chassi2 (1).CATPart
Estrutura/CADs de Estrutura/chassi2 (1).CATProduct
Estrutura/CADs de Estrutura/chassi2.CATPart
Estrutura/CADs de Estrutura/chassi2.CATProduct
Estrutura/CADs de Estrutura/chassi3.CATPart
Estrutura/CADs de Estrutura/corred1.CATPart
Estrutura/CADs de Estrutura/corred2.CATPart
Estrutura/CADs de Estrutura/estufa.CATProduct
Estrutura/CADs de Estrutura/portavasada.CATPart
Estrutura/CADs de Estrutura/prateleira.CATPart
Estrutura/CADs de Estrutura/reservatorio.CATPart
Estrutura/CADs de Estrutura/ventoinha.CATPart
Estrutura/CADs de Estrutura/vidro.CATPart
