PI2-Estufa/all-documents-PI2/Apresentações/Manual.docx

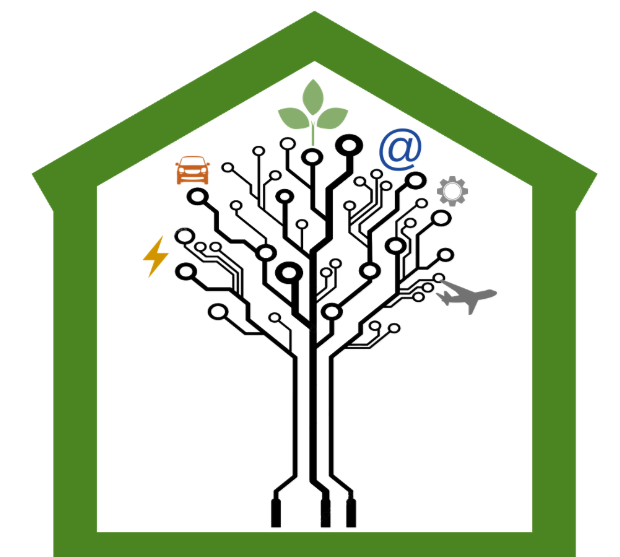
[picture p180: figure]

Quem somos Grupo interdisciplinar de de PI2 - Realizando projetos com eficiencia Contato Unb gama , proximo ao BRT. Gama,Brasília,DF,CNPJ Phone: 982112299 Email: myronrc@gmail.com Web: www.fga.unb.br Projetos integrados industria brasileira Gama,Brasília,DF,CNPJ | | | Greenhouse Estufa Hidropônica inteligênte Projetos integrados industria brasileira [Subtitle]

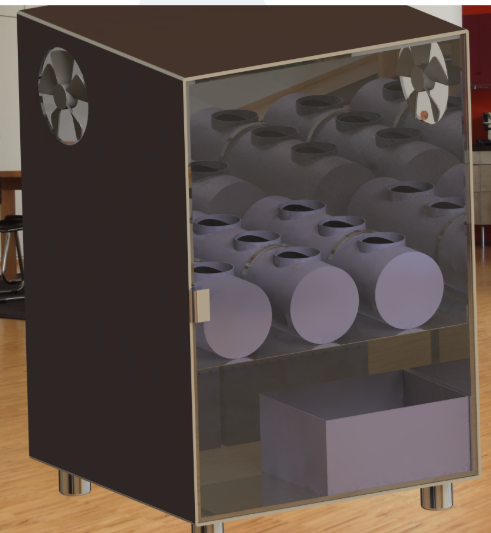
[picture p181: figure]
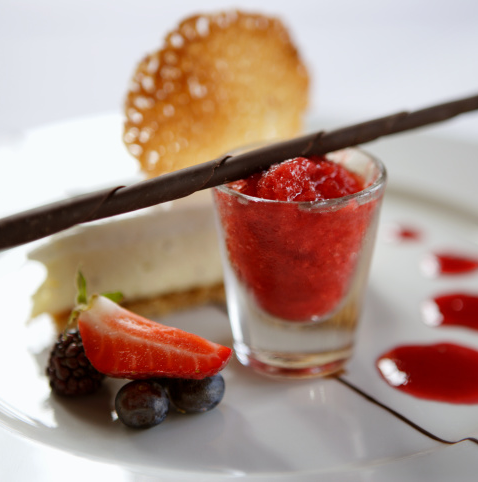
[picture p182: figure]
Closeup photo of an elegant dinner dish with artful plating
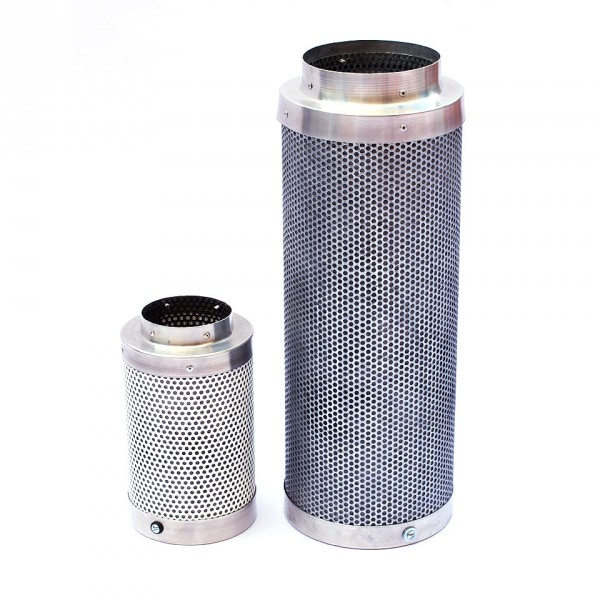
[picture p183: figure]

Tabela de conteudo Peças inclusas 1 Iniciando 2 Peças Inclusas 2 Como configurar seu plantario 2 Estufa hidropônica 3 Make It Your Own 4 Customize in Almost No Time 4 Make It Picture Perfect 4 Nossos Produtos 5 | | | | | Nossos produtos Estufa hidroponica V1.0 Unidade é capaz de criar um ambiente proprio para a germinação e crescimento de diversas plantas hidroponicas, possuindo acesso a wifi e app para controle e informação de sua preciosas hortaliças. Adaptador de germinação Adaptador para o crescimento inicial por sementes. Filtro de carvão ativado Filtro é vendido a parte e tem como finalidade suprimir odores as vezes indesejaveis de algumas especies plantadas.
| | | | 5

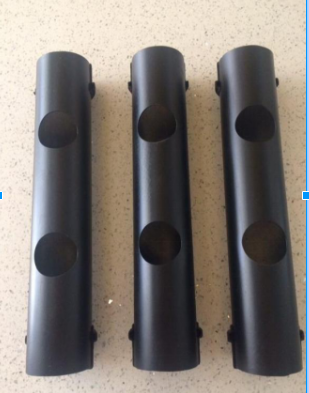
[picture p184: figure]
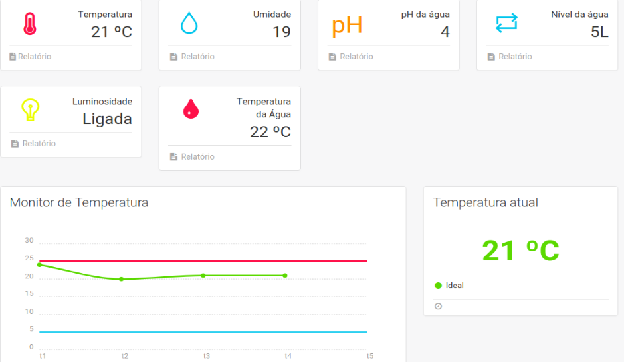
[picture p185: figure]
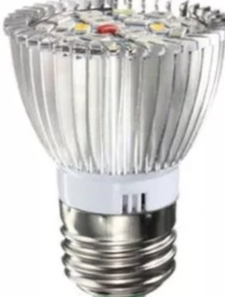
[picture p186: figure]

? No problem! Those galleries give you the option to add your own. Garantia de 1 ano par To replace any photo with your own, just right-click it and then click Change Picture. If your photo is not a flawless fit for the space, you can crop it to fit in almost no time. Just select the picture and then, on the Picture Tools Format tab, click Crop. | | | Peças inclusas Tubos de suporte de plantas Tubos de 9x9,2x3 e 4x4 são modelos disponiveis de acordo com o tamanho da espécie de planta pretendido. App de controle e monitoramento a distância. App Gratuito para download que permitem o acompanhamento de dados vitais para o crescimento e vida de sua hortaliça e controle de funções como troca de agua e movimento do plantario. Lâmpada especial Incluso 1 lamapada led Full spectrum com ultravioleta que acelera o crescimento da planta e infravermelho que mata os germes nocivos ás hortaliças.
4 | | | 1

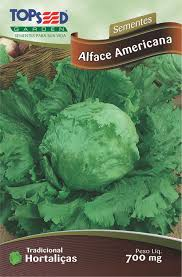
[picture p187: figure]

Iniciando Como Plantar? Utilize a amostra fornecida no adaptador com terra para iniciar a germinacão, plantar a semente com 0.5cm de profundidade e 3cm de distancia da proxima semente. Apos 25-30 dias estara pronta para ser replantada nos tubos de crescimento. Apos 75-80 dias estará em um tamanho proprio para ser consumido. Como configurar seu Plantário 1-Ligue a entrada de agua em uma fonte de agua em sua residencia. 2-Instale a lampada no bocal central e caso necessario utilize os bocais secundarios para ampliar a suprimento de luz da planta. | | | Ligue o equipamento na tomada se atentando para o modelo 110V ou 220V. 3-forneça os nutrientes solidos no reservatorio 4-Baixe o App e acompanhe sua plantação em qualquer lugar. Estufa hidropônica Desenho tecnico com dados na imagem
2 | | | 3
