PI2-Estufa/all-documents-PI2/(commit log)

2018-06-30 Add Energia' '
    [simulacao lamppontoapontorereflexo.xlsx]
2018-06-30 Add CADS
    [Chassi-Estufa-atualizado.CATPart, Product1.CATProduct, bandeja.CATPart, bracadeira1.CATPart, cano.CATPart, cassi3.CATPart, chassi.CATPart, chassi2 (1).CATPart]
