PI2-Estufa/all-documents-PI2/Fotos e vídeos/Fotos e vídeos/IMG_3915.JPG

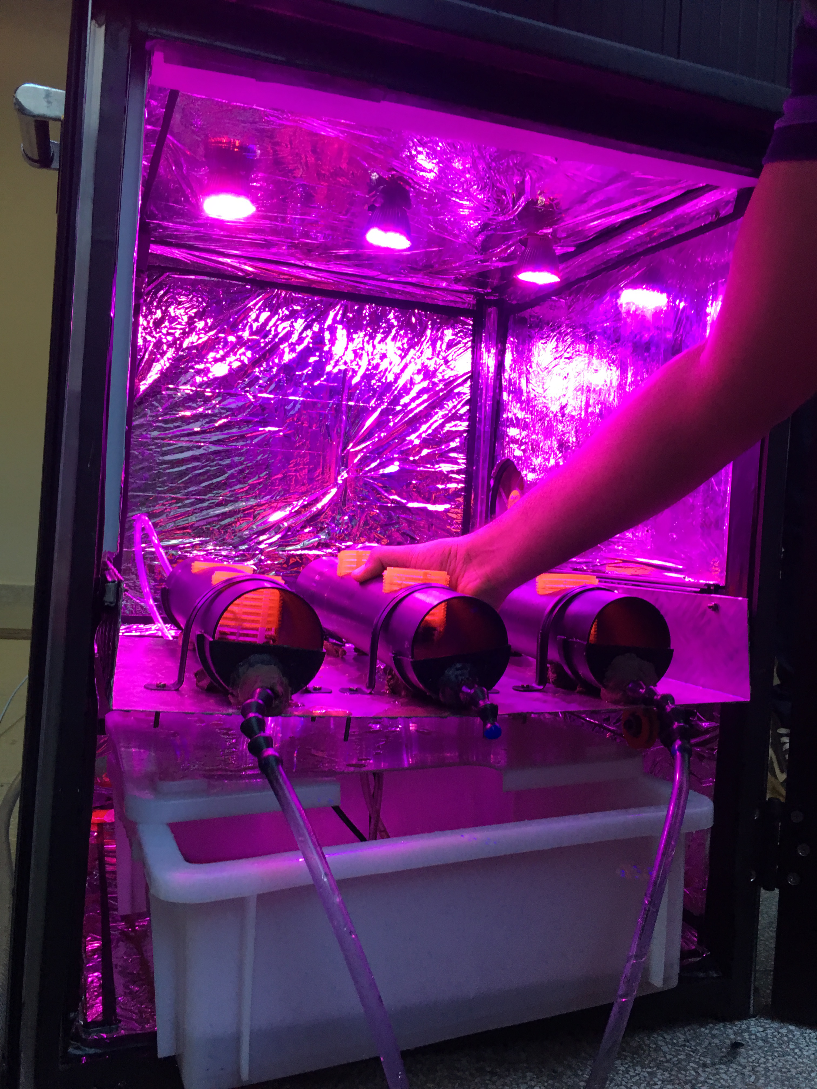
Fotos e vídeos/Fotos e vídeos/IMG_3915.JPG
